minhpham1810/thuoctracker/hardware/photos/README.md

# Add real build photographs here

Suggested files (not generated or claimed to exist):

- `assembled-front.jpg`: full cabinet, 5-inch screen and manual drawers.
- `assembled-rear.jpg`: power/USB exits and cable strain relief.
- `top-wiring.jpg`: Feather, amp, mic, encoder and the common GND connection.
- `base-screen-pi.jpg`: factory screen/Pi mounts, ribbon slack and cooler clearance.

Caption whether a photograph is assembled, a work-in-progress or a CAD render.
Use your own/consented photos. Crop faces, real medication labels, usernames,
passwords, API keys and private patient data. Do not substitute AI images for
evidence that the physical build fits or works. Keep images reasonably compressed.
