minhpham1810/thuoctracker/TEAM.md

# Who does what

## Status

Newest first. Everyone (and every agent) reads this after `git pull` and adds a line after pushing something others use. Format: `- HH:MM <name> (<area>): <what changed / what is ready / what you need to do>`.

- 05:55 Thanh (docs, in Minh Dau's `docs/demo-script.md`): **Demo script: Part A timing fixed, Part C added.**
  - Minh Dau: with `DEMO=1` a pill is missed 30 s after pill time (and re-announced every 10 s until then), so in the old Part A Mary's "What do I need to take now?" at 0:48 came after Metformin was already missed. Part A now uses that: Mary takes only the aspirin, the cabinet screen turns to its **"Did you take your Metformin?" Yes / Not yet** question (the touchscreen version of your phone popup), she taps Not yet, and only then asks "Did I take my pills today?" and "When is my next pill?". Please check it reads right to you.
  - New **Part C (0:30)**: a laptop screen recording of the dashboard's **Drug safety** panel for Mary: check clarithromycin, two FDA-label warnings (low blood sugar with metformin, muscle damage with atorvastatin), then one "Ask the labels" question. It shows the FDA labels in Tiger, which the video had nowhere. Time budget added so it stays at 5:00 (trim Scene 4 and the typing in Scene 3 first).
- 05:10 Minh Dau (ai, in Minh Pham's `ai/__init__.py`): **Voice answers "what do I take now / next / today?" exactly, from the schedule.** Before, Gemma read "What do I need to take now?" as advice (the prompt said "like whether to take a pill now") and answered "I don't know". Now `_schedule_answer()` handles those questions in Python before the model is asked: "It's pill time: the blue pill, Aspirin, 1 pill from box 1."; "Your next pill is at 8 in the evening: …"; "Today: 8 in the morning, Aspirin (blue pill), taken; …". A question naming a medicine or color ("when do I take my metformin / my red pill") covers only that one. A missed pill is never "take it": "Your 12 in the afternoon Metformin was missed; please ask your doctor before taking it late."
  - The model still answers "did I take…", "what is it for" and everything else; its advice rule is narrowed to real advice (a missed or extra pill, changing a dose, symptoms), and it's told that saying what's scheduled isn't advice. Thanh's grounding checks are unchanged.
  - `ai/test_ai.py`: the "When is my next pill?" case now expects the schedule answer (no model call); the prompt-content checks moved to "How many aspirin pills do I have left?". `python -m ai.test_ai` passes.

- 04:45 Minh Dau (backend): **New pill-time announcement, every pill due now named once:** "Hi, Grandma Lan, please pay attention. You have a blue pill and a red pill. Aspirin and Metformin, now." The cabinet says it (ElevenLabs; `time_for_pill` backup sound if offline) and the screen shows it as the message. Pills due the same minute share **one** announcement: the scheduler creates all of that minute's doses first, then announces.
  - Thanh: with several pills at once, each still gets its own command, but only the first has `say_url`/`sound`; the others have both `null`. `pi/main.py` already handles that (no audio = nothing played). Tested in a throwaway schema (6 checks).

- 04:40 Thanh (backend labels): **53 FDA labels now** (15 more, already in the shared database): donepezil, memantine, tamsulosin, oxybutynin, alendronate, allopurinol, colchicine, levodopa (Sinemet), hydrochlorothiazide, carvedilol, meloxicam, trazodone, mirtazapine, zolpidem, pantoprazole. The interaction check also got more accurate: a drug class both drugs share no longer hides real effect warnings (an opioid label's "other CNS depressants" now catches zolpidem), class matches must be in a sentence about using drugs together (no more antidepressant suicidality warnings), and "strong CYP3A4 inhibitors" in a label now matches clarithromycin, fluconazole, diltiazem. Restart your backend to get it; nothing to ingest.
- 07:45 Thanh (cabinet screen): **The cabinet screen asks "Did you take your pill?" too**, so patients without their phone can answer at the cabinet. Same rules as Minh Dau's phone popup: a dose past its time, not confirmed, under 3 h ago; **Yes, I took it** / **Not yet** (asks again in 30 min); it only asks, never "take it now". It shows when no pill is being given right now (that keeps its own "I took it"), lights the pill's box, and uses a calm look instead of the red "missed" screen. Yes = the existing `POST /cabinet/{id}/taken?dose_id=`, so a missed dose sends Minh Dau's "Taken late" push and the phone popup goes away on its next check. No backend or contract change.
  - Thanh: rebuild and restart the :3000 web server; the Pi kiosk picks it up on reload (`pkill chromium`).
- 04:20 Minh Dau (app + backend): **"Did you take your pill?" popup on the patient's phone.** When a pill is due it pops up with **Yes, I took it** / **Not yet** per pill; Not yet asks again in 30 minutes; ✕ stops asking about those pills. Two pills due at once show together. It stops asking 3 hours after the pill's time, and only asks: it never says "take it now" (late double-dose risk). Yes = the same `POST /doses/{id}/taken` as "I took it".
  - Backend: Yes (or the cabinet's "I took it") on a dose already marked missed pushes the family and doctor "Taken late: Grandma Lan took Metformin (12:00) late, at 12:47." Tested in a throwaway schema (4 checks).
  - Snoozes live on the phone: reopening the app asks again right away.

- 07:20 Thanh (backend labels, ai one function, doctor dashboard panel): **Doctor AI: FDA labels for interactions and side effects** (ported from my HealthCare RAG project). 38 common drugs' DailyMed prescribing labels are now in our Tiger database: 2,886 chunks of the clinical sections, each with a MiniLM vector (pgvector + pgvectorscale DiskANN index) and a tsvector. Search ranks both ways in one SQL statement and fuses them (Reciprocal Rank Fusion). Two doctor-only routes, in the contract: `GET /patients/{id}/interactions?add=` (no AI: the sentence where one label names the other drug, plus known CYP/P-gp/additive pathways) and `POST /ai/drugs` (local Gemma answers only from numbered label passages, cites `[n]`, every number must be in a cited passage; label interaction warnings are returned separately so the model can't drop them). Dashboard: a new "Interactions and side effects" section in each patient's chart, with "Check a drug you're considering" and "Ask the labels".
  - Everyone running a backend: `git pull`, `ollama pull all-minilm` (46 MB; without it search is keyword-only), restart the backend. Nothing to ingest: the labels are already in the shared database (`python -m backend.labels ingest` refills them).
  - Minh Dau: new `backend/labels.py` (tables `drug_labels`, `label_sections`, `label_chunks`, `label_lexemes`, created on start), the two routes in `main.py` next to `/ai/ask`, and `labels.ensure_schema()` in `lifespan`.
  - Minh Pham: in `ai/__init__.py` I added `answer_from_labels` + `LABELS_DONT_SAY` + `_unsupported` only; on the web, `web/app/doctor/drug-labels.tsx` (new), one line in `dashboard.tsx`, styles at the end of `doctor.css`.
- 03:50 Minh Dau (backend + app + web): **Appointments are a month calendar now, 3 months ahead.** Doctor (dashboard Schedule tab and the app): tap a day to see its times and open new ones, with **Repeat: every <weekday> for 4, 8 or 13 weeks**, so 3 months take one click. Green days have open times; a teal dot means booked visits. Patient and family (app Visits tab): the same calendar shows which days the doctor is available; tap a green day, pick a time, book.
  - Contract: `GET /schedule` now covers 92 days by default (up to 120); `POST /availability` takes `repeat_weeks` (0-13) and inserts all the times in one statement (13 weeks of afternoons took 0.7 s).
  - Pull, restart the backend, reload the app and the dashboard. Tested in a throwaway schema: 8 new checks plus the 21 earlier ones.

- 03:20 Minh Dau (web, in Minh Pham's folder): **The doctor dashboard has a Schedule tab** next to Alerts and Messages. The doctor opens times (day, from/to, 15/30/60 min), sees each booked visit with the patient and reason (click the name to open their chart), and can remove an open time or cancel a visit (two clicks; the patient and family are told). Each patient's chart header shows **"Next visit …"**. It uses the appointment routes from the 03:00 line; `GET /schedule` joins the 3 s refresh.
  - Minh Pham: files touched: new `web/app/doctor/schedule.tsx`; `dashboard.tsx` (third tab, `slots` in `Data`, `visit` prop on `PatientView`); `lib/api.ts` (`Appointment` type); `components/icon.tsx` (`calendar`); `doctor.css` (schedule styles); `layout.tsx` (`suppressHydrationWarning` on `<html>`/`<body>`: a custom-cursor browser extension added attributes and caused the "1 Issue" hydration error). `tsc` and `eslint` pass.

- 03:00 Minh Dau (backend + app): **Doctor appointments.** The doctor opens times (a day, from-to, 15/30/60 min per visit) and sees who booked and why. The patient, or their family on the patient's behalf, books a time with an optional reason and can cancel it (the time opens again). Pushes: the doctor on each booking or cancel, the patient and family when the doctor cancels, and an "Appointment soon" reminder one hour before. No double booking even across backends; patients never see other patients' bookings. Routes are in the contract under "Appointments"; new table `appointment_slots`, created on the next backend start. `/demo/reset` seeds 4 times tomorrow 9:00-11:00 for Dr. Nguyen, Grandma Lan booked at 10:00.
  - App: the doctor gets tabs **Patients | Schedule**, the patient and family **Today | Visits | Care team**. Pull and reload (`r` in Expo).
  - Minh Pham: optional, the dashboard could show the doctor's schedule from `GET /schedule` (same doctor login).
  - Tested in a throwaway schema: 21 checks (privacy, family booking, double booking, cancel/reopen, doctor cancel notifies, past and overlapping times, roles, reminder once).
- 02:45 Thanh (ai, safety): **Voice answers can no longer invent doses.** With an empty or short log, Gemma 4 made doses up every time ("You took metformin at 8:00 AM and 8:00 PM" for Mrs. Hoa, who has no doses and no metformin: 6 of 6 tries), against the hard rule. `ai.answer` now: an empty log answers "There are no doses in your log yet." without the model; a question about a medicine not in the log answers "Your log doesn't mention X." from the data; and every medicine, pill color and time in the model's answer must be in the log (or be "now"), otherwise it says `DONT_KNOW` (and logs `[ai] answer not in the dose log (...)`). Tested: 11 canned cases (no model) plus live on Mrs. Hoa (empty) and Grandma Lan (true answers still pass).
  - Minh Pham: this is in your `ai/__init__.py` (`answer`, plus `NO_DOSES`, `COMMON_DRUGS`, `PILL_COLORS`, `TIME_RE`, `_ungrounded`); `python -m ai.test_ai` still passes.
- 02:15 Thanh (pi, screen route): **The screen shows a voice answer as the cabinet says it** (it was ~2 s early: the Pi still had to download, convert and send the audio to the ESP32). `/ai/ask` no longer saves the answer for the screen; the Pi posts it to the new `POST /cabinet/{id}/answer` right when the ESP32 has the audio, or anyway if playback fails. Contract table updated.
  - Minh Dau: that route is in `backend/main.py` next to `GET /cabinet/{id}/answer`; `/ai/ask` is back to just returning `{text, audio_url}`.
  - Thanh: on the Pi `git pull` and `sudo systemctl restart cabinet.service`.
- 02:05 Thanh (ai one setting, backend one line, screen, pi): **Voice answers come out right after they appear.** `ai.speak` now uses ElevenLabs `eleven_flash_v2_5` (same Rachel voice): ~0.75 s per sentence vs ~1.6-2 s for `eleven_multilingual_v2` (measured with our key). `ELEVENLABS_MODEL` in `.env` switches back. `/ai/ask` saves the answer for the screen only after its MP3 exists, and the screen checks every 0.5 s, so the text no longer shows seconds before the cabinet speaks. The Pi now checks commands every 0.5 s (screen tap to voice ~0.3-0.8 s) and converts each sound once. `pi/sounds/listening.mp3` re-recorded with the fast model.
  - Minh Pham: in your `ai/__init__.py` I only added `VOICE_MODEL` (env `ELEVENLABS_MODEL`) and used it in `speak`.
- 01:55 Minh Dau (app + backend): **Phone label scans: the real fix.** The 01:30 `File` workaround still failed on phones with "Unsupported FormDataPart implementation". The app now skips form uploads entirely: the picker returns the photo as base64, and the app sends it as JSON to the new `POST /ai/label64` `{image}`, which runs exactly the same label reading as `/ai/label`. Tested end to end with a phone-size photo; all 4 checks pass. The web dashboard keeps using `/ai/label`, which works in browsers.
  - Everyone: `git pull`, restart the backend, and reload the app (`r` in Expo).

- 01:45 Thanh (cabinet screen + pi; 2 backend routes): **The screen's "Ask a question" works on the Pi now.** The kiosk's browser can't use the ESP32's mic, so when the browser has no mic the button asks the cabinet instead: `POST /cabinet/{id}/ask` queues an `ask` command, the Pi says "I'm listening", records on the ESP32, calls `/ai/ask`, plays the answer; the screen shows "I'm listening" / "Let me check" and then the answer from `GET /cabinet/{id}/answer`. Laptops with a mic still record in the browser. Contract table updated.
  - Minh Dau: I added those two routes and a `cabinet_answer` table (one row per patient: last answer text + time) to `backend/main.py` / `db.py`; `/ai/ask` now also saves its answer there, and `/cabinet/{id}/command` drops an `ask` older than 30 s. Also in `seed()`'s TRUNCATE.
  - Thanh: on the Pi `git pull` and restart `cabinet.service` (it runs the ask), then reload the kiosk.
- 01:30 Minh Dau (app): **Fixed phone label scans failing with "Unsupported FormDataPart implementation".** In Expo SDK 58, `fetch` rejects React Native's old `{uri, name, type}` form part, so the photo never reached the backend. The app now uploads it as an `expo-file-system` `File`, which SDK 58 accepts. Also, the add-medicine form no longer starts pre-filled with "1 pill / 08:00 / 30", which looked like a scan result when nothing had been read. Fields start empty, with "e.g." hints. Pull and reload the app (`r` in Expo).

- 01:40 Thanh (pi + esp32): **Voice works end to end on the real cabinet.** Pi `esp32 ask` (or a talk button): the ESP32 speaker says "I'm listening. Please ask your question.", the INMP441 records 5 s, the laptop's local Gemma 4 answers from the dose log, the answer plays on the ESP32's 8 Ohm speaker. The board runs the teammate's `code.py` (volume knob + mute, Hall off, `status`) merged with the new `audio` command; it and `boot.py` are now in `pi/esp32/`. Fixes found on hardware: S3 USB endpoint limit (drive hidden in normal runs), a Linux echo at port open (ping handshake), and a CircuitPython bug where one big `readinto()` stops at half (board reads in 4 KB blocking chunks).
  - Everyone: **update the board from the Pi with `.venv/bin/python pi/esp32/push.py code.py`** (no buttons). Editing mode for the drive: hold the knob in while tapping RESET. Never hold BOOT during RESET (that's the ROM bootloader).
  - `pi/.env` on the Pi: `AUDIO=esp32` and no `audio` in `MOCK`. Stop `cabinet.service` while running bench commands, start it after.
- 00:30 Minh Dau (ai + backend): **Fixed "Couldn't read the label" for everyone.** Cause: our shared Gemini key's free tier allows `gemini-3.5-flash` only about 1-2 image requests a minute, shared by every laptop, and the Gemini fallback sent the full 3+ MB phone photo. Every scan got `429 Too Many Requests`.
  - Labels now use **`gemini-3.5-flash-lite`**: 4 scans in a row read correctly, about 7 s each.
  - The photo is shrunk for Gemini too, and a 429 waits the delay Gemini asks for (max 15 s) and retries once.
  - The app and dashboard now show the real reason on failure, e.g. "label reader failed: local model: 500 …; Gemini: 429 Too Many Requests".
  - **Minh Pham:** your Mac should have read labels with local `gemma4:e4b-mlx` before ever reaching Gemini. Scan once and check the app's message or your uvicorn console for `[ai] Ollama label read failed (...)`; that says why the local model failed (e.g. MLX not supporting images or `format`). Tell me what it says.

- 23:10 Thanh (ai, one line): **Voice questions also run on Windows/Linux with an NVIDIA GPU.** `OLLAMA_MODEL` in `.env` picks the Ollama model (default stays `gemma4:e4b-mlx` for the Mac). `gemma4:e4b` (the non-MLX build) hears audio on Ollama 0.40.5: tested on Thanh's laptop (RTX 5070) with exact transcripts, ~2 s per step once loaded, ~30 s for the first load; `/ai/ask` end to end ~7-8 s with ElevenLabs. Your label change picks up the same `gemma4:e4b` here, which is already pulled. The demo backend on Thanh's laptop now uses it, so voice no longer depends on Gemini's 20-a-day free quota (labels still do).
  - Minh Pham: I edited your `ai/__init__.py` (only `OLLAMA_MODEL = os.getenv(...)` plus a comment). The ESP32 audio path itself was tested on the Pi earlier (with the fallback answer).
- 21:45 Minh Dau (ai): **Label scanning now prefers Gemma 4** (order: gemma4, qwen2.5vl, llama3.2-vision, minicpm-v, llava). This replaces the setup steps in the 21:30 line below.
  - **Minh Pham (Mac):** nothing to pull. The `gemma4:e4b-mlx` you have for voice reads labels too, and the model is already loaded.
  - **Thanh (Windows):** `ollama pull gemma4:e4b` (the regular build, ~6.6 GB). The `-mlx` versions run only on Apple Silicon. Then `git pull`, `.venv\Scripts\pip install -r backend\requirements.txt`, and restart the backend.

- 21:30 Minh Dau (ai + backend): **Label scanning runs on local Ollama, on Windows or Mac.** `ai.read_label` sends the photo to a local vision model first and falls back to Gemini on a laptop without Ollama. Same output as before (`{name, dose, times, expiration, quantity}`), so the phone app and dashboard autofill are unchanged.
  - **Thanh (Windows) and Minh Pham (Mac):** install Ollama, run `ollama pull qwen2.5vl:7b` once (~6 GB), then `git pull`, `.venv\Scripts\pip install -r backend\requirements.txt` (adds Pillow), and restart the backend. It picks the first installed of `qwen2.5vl`, `gemma4`, `llama3.2-vision`, `minicpm-v`, `llava`, or `OLLAMA_VISION_MODEL` in `.env`. On the Mac, the `gemma4:e4b-mlx` already there for voice is the backup if qwen isn't pulled.
  - Photos are shrunk to 1280 px first. Local models answer loosely, so the result is cleaned (`8:00` → `08:00`, bad dates and times dropped, `"60 tablets"` → `60`) and anything unreadable stays empty for a person to fill in, never made up.
  - The app now waits up to 150 s for a scan; the web proxy allows 120 s.
  - Offline tests: `python -m ai.test_ai` (new cases: Ollama path, model choice, clean-up, Gemini fallback, no-model error). Not yet tried with real Ollama: please scan one real bottle on each laptop.

- 20:45 Minh Dau (app + backend): **Scan a medicine label with the phone.** In the mobile app, the doctor or the family opens the patient's Today tab → "Scan a label to add a medicine" → takes a photo (or picks one). Gemini fills in the name, dose, times, expiration and pills in the bottle. They choose a free box (1-7) and a pill color, check every field, and save. If a medicine with the same name is already there: "Aspirin was already added (box 1). Are you sure you want to add it again?"
  - Contract: `POST /medicines` now allows the patient's **family** too, not only the doctor. `/ai/label` allows family and returns a new `quantity` field. Edit and delete stay doctor-only.
  - Minh Pham: `LabelDraft` in `web/lib/api.ts` can gain `quantity: number | null` to prefill pills left on the dashboard (optional).
  - The app now uses `expo-image-picker` (camera). It works in Expo Go now; the Android APK needs a rebuild (Minh Dau is starting one), and until then the old APK says "no camera support" instead of crashing.

- 20:15 Thanh (pi): **ESP32-S3 audio unit over USB.** The speaker (MAX98357A) and mic (INMP441) are on the ESP32 (CircuitPython with `audioi2sin`); the Pi controls it over one USB cable. `pi/esp32/` has `boot.py` + `code.py` to copy onto the board and a setup README (stored sounds as 16 kHz mono WAV in `/sounds`). With `AUDIO=esp32` in `pi/.env`, `pi/main.py` plays the stored sounds and the ElevenLabs answers through it (MP3 converted on the Pi), `record_question` works, and an optional talk button on the ESP32 records a question -> `/ai/ask` -> plays the answer. Bench: `python pi/main.py esp32 ping|play good_job|rec 3|ask`. Tested against a fake board only; needs a run on the real one. New Pi dependency: `pyserial`.
  - Duy: copy `pi/esp32/boot.py` and `code.py` to the board, add the 4 WAVs, plug it into a black USB port on the Pi; set `BUTTON_PIN` in `code.py` if you wire a talk button.
- 20:00 Minh Dau (backend): **Several backends can now run at the same time on the shared database.**
  - **One scheduler:** only one backend runs it, whichever holds the `scheduler_lease` row in the database. If that laptop stops, another backend takes over within about 15 s and catches up on doses due in the gap. `GET /health` returns `"scheduler": true` on the one running it.
  - **Shared state:** the Pi command queue, cabinet screen state, "alerts already sent" and reminder times moved from process memory into tables (`cabinet_commands`, `cabinet_state`, `alerts_sent`, `doses.reminded_at`). The Pi, the cabinet screen and the dashboard can each talk to any backend.
  - **No duplicates:** each scheduler step is a conditional write, and the database allows only one dose per medicine per pill time (`doses_one_per_time`). Even if two schedulers overlap briefly, nothing is sent twice.
  - **Tested** with two backends at once against a throwaway schema, never the real tables: pill time on B reached the Pi via A; "I took it" on B showed on A; missed and expiring alerts went out exactly once to family and to doctor; after hard-killing the scheduler backend, the other took over.
  - No contract change for the Pi, web or app. New tables are created on the first start of the new code.
  - Everyone: keep laptop clocks on automatic time. Dose times still use each laptop's local clock.

- 19:45 Thanh (pi + cabinet screen): **Cabinet sign-in now accepts any patient account** (doctor/family still refused). `pi/kiosk.sh` opens plain `/cabinet`; an old `?hw=1` URL also works. Heads-up: the Pi's speaker and mic still follow `PATIENT_ID` in `pi/.env`, so sign the screen in as that same patient (Grandma Lan = 1) or the screen and the hardware will show different people. `?patient=N` still skips the sign-in.
- 19:25 Thanh (pi + cabinet screen): **Cabinet sign-in: a one-time setup on the Pi.** `/cabinet?hw=N` (what `pi/kiosk.sh` now opens; N = `PATIENT_ID` in `pi/.env`) asks once for patient N's email + password on a big built-in keyboard and remembers it; only that patient's account is accepted, so the screen always matches the Pi's boxes. Doctor/family accounts are refused; the login session is ended right away (the cabinet routes stay login-free). Menu has **Switch patient** (Cancel, or it goes back after 1 min idle). `/cabinet?patient=N` still works with no sign-in, for laptops and the demo. `kiosk.sh` dropped `--incognito` so the sign-in survives reboots. No backend change.
  - Thanh: on the Pi, `git pull`, then restart the kiosk (`pkill chromium`) and sign in once as lan@demo.com.
- 18:56 Minh Pham (app): **Fixed `npx expo start` asking to install the old global `expo-cli`.** `app/package.json` had been downgraded to `"expo": "^44.0.6"`, probably by an `npm install` when `expo-file-system` was added. Set back to `~58.0.19` and reinstalled (`npx expo --version` = 58.1.15).
  - Everyone: `git pull`, then `cd app && npm install`. Add Expo packages only with `npx expo install <pkg>`, never `npm install <pkg>`, and don't run `npm audit fix --force`: both can downgrade Expo again. If `npx expo start` offers to install `expo-cli` globally, say no.
  - Expo Go QR: on iPhone scan with the Camera app; on Android scan from inside Expo Go. Or in Expo Go tap "Enter URL manually" and type the `exp://…:8081` address it prints. Update Expo Go first (SDK 58). If the phone can't reach the laptop, use `npx expo start --go --tunnel`.

- 18:50 Minh Dau (backend + app): **The family now gets the pill-time push too**: "Time for Grandma Lan's blue pill (Aspirin), slot 1." Many older patients don't use a phone, so the family can call or help. It's sent once when the dose starts, not on every repeat reminder. In the app, the family's in-app banner shows it too (for phones without push).

- 18:40 Minh Dau (backend + app): **Alerts now go to more people.** A missed dose alerts family **and doctor**, and the patient gets an inform-only push: "You missed your 12:00 Metformin. Your family and doctor have been told." It never says "take it now", because a late pill could double up with the next dose. Expiring soon now alerts family **and doctor**. Low pills is unchanged (doctor + family). In the app, the patient's in-app banner also announces a missed dose (for phones without push).
  - Minh Pham: there are now two alert rows per missed or expiring event (`to: "family"` and `to: "doctor"`), the same as low pills already had. The dashboard may want to show only the doctor rows.
  - Heads-up: a backend test of mine ran `/demo/reset` on the shared Tiger Data database around 18:30, so anything added since the last reset was wiped back to the demo seed. Sorry. I won't test against the shared database again.

- 18:30 Thanh (cabinet screen): **Cabinet screen: dark theme + Menu button** (`web/app/cabinet/*` only, no contract change). A Menu button sits top-left. It opens: Screen Light / Dark / Auto (Auto = dark from 7 PM to 7 AM, the default), Text size Normal / Large, and Today's pills (every dose today with its box and Taken / Missed / Due now / Coming up). Tapping the Today strip also opens that list. Choices are saved in the Pi's browser. The menu closes on its own after 30 s and whenever a pill is due. Dark keeps 4.5:1 contrast everywhere.
  - Thanh: restart the :3000 server (`cd web && npx next start -H 0.0.0.0 -p 3000`) so the Pi shows it.
- 18:15 Thanh (cabinet screen): **Cabinet screen polish + accessibility pass** (`web/app/cabinet/*` only, same behavior and layout). The cabinet picture now looks like the real thing: teal body, white drawer fronts with pulls, empty boxes as dark recesses; the box to open lifts and glows with OPEN, the rest fade. Pill colour is a capsule in each box's corner; "box N" on the take screen is drawn like the glowing box. Bigger text everywhere (nothing under 14px at 800x480), Today strip shows at most 4 doses so names fit, the hero shows a mic while you ask, the lit box uses the mode colour (green taken, amber already took, red missed). A11y: box labels read pills left, refill and expiry in full; Today chips say taken/missed for screen readers; details card takes focus, closes on Escape, and the page behind it is inert. No contract change.
  - Thanh: the :3000 server reads `web/.next`, which this build rewrote: restart it (`cd web && npx next start -H 0.0.0.0 -p 3000`) so the Pi shows the new design.
- 18:05 Minh Dau (app + backend): **Real push notifications on Android.** The app is a development build now: Expo project `@minhdeptraivcl/thuoctracker` with Firebase FCM set up. Install the APK on Android phones: https://expo.dev/artifacts/eas/eGW9mu9nQSFXYmpwcVxmKkgN8vcxr0A8b4TIdMBRKus.apk
  - To run: on the laptop, `cd app`, then `$env:REACT_NATIVE_PACKAGER_HOSTNAME="192.168.137.1"; npx expo start`. Open the installed ThuocTracker app (not Expo Go), log in, and allow notifications. Alerts, pill time and chat then push even with the app closed.
  - iPhone: keep using Expo Go with `npx expo start --go`. Plain `npx expo start` now opens the development build.
  - Network: Minh Dau's laptop hotspot. Backend `http://192.168.137.1:8000`, web `http://192.168.137.1:3000`. Thanh: `BACKEND_URL=http://192.168.137.1:8000`, kiosk `http://192.168.137.1:3000/cabinet?patient=1`.
  - Push failures print as `[push error] …` in the uvicorn console.
  - Minh Pham: the dashboard's "Push sent to … phone" line appears even when no phone is registered. It's true now only if the family or doctor is logged in on a development build.

- 17:30 Thanh (pi + cabinet screen): **Contract change: the cabinet has 7 boxes, `Medicine.slot` is now 1-7.** Boxes 1-3 top row, 4-6 middle row, 7 a long box across the bottom; every box holds pills like a slot. Additive: slots 1-3 still work. Changed `models.py`, `web/lib/api.ts` (`SLOTS`, `LONG_SLOT`), the add-medicine slot picker and the dashboard's prescription cards (filled boxes plus one "add" card). **Cabinet screen redesigned** as a picture of the cabinet: the box to open glows with OPEN and the rest fade, each box shows its pills left with "Refill soon" / "Expires in N d", tapping a box opens its details, the take screen says "Open box N · take <dose>", and a Today strip along the bottom shows taken / missed / due / coming doses. Tested on the Pi touchscreen (800x480). Also: the Pi now boots straight into the kiosk with the mic flags (`pi/setup.sh`).
  - Minh Dau: please check the slot change is fine with the backend; nothing else in the backend needed changing.
  - Minh Pham: I edited `web/app/cabinet/*` and two doctor files (slot lists only). On the Pi, serve the web app with `npm run build && npx next start -H 0.0.0.0`: dev mode blocks the Pi's browser (cross-origin dev resources).

- 16:25 Minh Pham (web + ai): **Cabinet screen: "Ask a question" button** (records in the browser -> `/ai/ask` -> shows the answer big and plays the ElevenLabs MP3). Hidden while a pill is due. `ai.transcribe` now detects WAV/WebM/MP4/OGG/MP3 by itself.
  - NEED Thanh (pi): Chromium only allows the mic on https or localhost. Start the kiosk with `--unsafely-treat-insecure-origin-as-secure=http://<laptop-ip>:3000` or the Ask button says the mic isn't available. If the Pi mic is unreliable, keep using `record_question` + `/ai/ask` from `pi/main.py`.
- 16:08 Minh Pham (ai): **All the `ai/` functions are real now** (Gemini `gemini-3.5-flash` + ElevenLabs over `requests`, no new SDKs; tested live: speak, transcribe, answer). The backend's existing `try_ai` wiring picks them up, nothing to change. Checked the whole flow offline with faked APIs: `/ai/label`, `/ai/ask` -> MP3, pill time -> SMS + `say_url`. Test: `python -m ai.test_ai`.
  - Everyone: put `GEMINI_API_KEY` and `ELEVENLABS_API_KEY` in `.env` and restart the backend. Optional `ELEVENLABS_VOICE_ID`.
  - Minh Dau: I touched `backend/` only for a docstring, and fixed `.gitignore` (`.DS_Store` and `audio/` were on one line, so `audio/` MP3s were not ignored).
- 17:20 Minh Dau (backend): **Pulled Thanh's Pi loop: it matches the contract.** I fixed one backend bug it exposed. A Pi command cycle takes longer than the 10 s demo reminder, so commands piled up and an old reminder could replay after the pill was taken. Now at most one pill-time command per dose waits in the queue, and taking the pill or missing the dose removes it. Thanh: no change needed on the Pi; audio-only commands (`good_job`, `missed`) still arrive as before.
- 16:55 Minh Dau (backend): **Done: the backend no longer serves `web/`** (Minh Pham's NEED). Port 8000 is now API + `/audio/` only, and `web/` files return 404. I checked every route the Next.js pages call (`/patients`, `/alerts`, `/medicines`, `/doses/{id}/taken`, `/cabinet/{id}/state`, `/ai/label` with field `photo`, `/demo/*`): all exist with matching shapes.
  - Minh Pham: `LabelDraft` allows `null` fields. Return `None` from `read_label` for anything unreadable and the backend passes it through. Chat on the dashboard is optional; the mobile app already has it.

- 15:50 Minh Pham (frontend): **Doctor dashboard + cabinet screen are live on the real API**, now a Next.js app in `web/` (whole folder is mine). Run `cd web && npm install && npm run dev` → dashboard `http://<laptop-ip>:3000/doctor`, cabinet `http://<laptop-ip>:3000/cabinet?patient=1`. The browser calls `/api/*` on :3000, which proxies to the backend (`BACKEND_URL`, default `http://localhost:8000`), so no CORS needed. Dashboard has "Pill time now" (calls `/demo/pill_time`) and "Add medicine" (label photo → `/ai/label` → form → `POST /medicines`).
  - Minh Dau: the dashboard moved from static `web/doctor` to Next.js, so it is no longer served on :8000. It handles cabinet `mode: "missed"` and the new alerts; chat on the dashboard is not built yet.
  - NEED Thanh (pi): the kiosk URL is now `http://<laptop-ip>:3000/cabinet?patient=1` (port 3000, not 8000).
  - NEED Minh Dau (backend): please delete the `app.mount("/", StaticFiles(directory="web", ...))` line in `backend/main.py`. `web/` is Next.js source now, so that mount would serve `node_modules`, `.next` and any `web/.env*` file to anyone on the hotspot.
- 16:40 Minh Dau (app): **First version of the mobile app is in `app/`.** Pick a role (patient, family or doctor). The doctor sees all their patients with taken/missed counts and refill badges; each patient has a Today tab (medicines, pills left, alerts, dose history, "take your pill" banner) and a Chat tab shared by patient, family and doctor. Phone notifications show while the app is running; real push turns on after `npx eas init` (Android also needs a development build). To try it: `cd app && npm install && npx expo start`, open it in Expo Go, and enter `http://<laptop-ip>:8000`. Nobody else needs to change anything.
- 16:00 Minh Dau (backend + app): **Adding a mobile app** (Expo, in `app/`, built by Minh Dau) for patients, families and doctors, with a chat per patient and push notifications. The backend part is ready: chat routes, push registration, and every alert sent by both push and SMS (see "Mobile app" in the contract). Added a 3rd sample patient, Mrs. Hoa.
  - Minh Pham: the web doctor dashboard stays (it's the big screen at the judging table), with no change needed. Optional: show the patient chat on the dashboard with `GET /patients/{id}/messages`.
- 15:35 Minh Dau (backend): **The AI routes now call `ai/`.** `/ai/label` and `/ai/ask` call `read_label`, `transcribe`, `answer` and `speak`. A function that still raises `NotImplementedError` gets a fake answer, so Minh Pham can push one function at a time and it goes live with no backend change.
  - Minh Pham: match the signatures in `ai/__init__.py` exactly. `answer(question, log)` receives the dose-log shape in this file (contract change 4). `speak` returns MP3 bytes; the backend saves them and serves them at `/audio/…`. Make sure `import ai` never crashes, or the backend won't start.
  - Thanh: `say_url` and `audio_url` become real MP3 links (prefix with `BACKEND_URL`) once `speak` is written; while they're `null`, play the backup `sound`. After a dose the Pi also gets `{"sound": "good_job"}` or `{"sound": "already_took"}`.
- 15:20 Minh Dau (backend): **The scheduler is running.** Pill time starts a dose on its own, the reminder repeats, a dose with no pill taken is marked missed, and the low-pills and expiring alerts fire once each. Texts go through Twilio, or are printed to the console when `.env` has no keys. Put `DEMO=1` in `.env` for the 30 s missed / 10 s reminder timing.
  - Thanh: **contract change.** A command may be audio only (e.g. `{"dose_id": 7, "sound": "missed"}`): just play the sound. The same `dose_id` can arrive again as a repeat reminder: play it again.
  - Minh Pham: the cabinet `/state` can now be `mode: "missed"`. New alerts appear in `/alerts` on their own, so poll with `?since=`.
- 15:10 Minh Dau (backend): **API is live on in-memory sample data.** Every route in the contract below works with the exact JSON shapes. Run `uvicorn backend.main:app --reload --host 0.0.0.0` from the repo root, or use Minh Dau's laptop IP on the hotspot, port 8000. Fake pill time: `POST /demo/pill_time?medicine_id=1`; reset: `POST /demo/reset`.
  - Minh Pham: build the dashboard on `/patients`, `/patients/{id}/medicines`, `/patients/{id}/doses`, `/alerts`; the cabinet screen polls `/cabinet/1/state`. `/ai/label` and `/ai/ask` return fixed fake answers until your `ai/` functions are pushed. Add a Status line when each one is ready.
  - Thanh: the Pi polls `/cabinet/1/command`. `say_url` is `null` for now, so play the backup sound named in `sound`.
  - `models.py`: `Patient.phone` (required) and `Doctor.phone` (optional) were added.
  - Not done yet: the scheduler (timed reminders, missed doses, low and expiring alerts) and Twilio.

4 people. Each person owns **folders**, not features, so nobody edits the same file. Duy joins later for the physical build.

| Person | Owns (only you edit these) | Done means |
|---|---|---|
| **Minh Dau**: Backend + mobile app | `backend/` (all of it: `main.py`, `models.py`, rules, Twilio, push, the `/ai/*` route wrappers) and `app/` (Expo mobile app for patient, family, doctor: chat + push) | Every endpoint below returns real data; alerts and texts fire on their own |
| **Minh Pham**: AI + Frontend | `ai/__init__.py`, `web/` (Next.js: `/doctor`, `/cabinet`) | The 5 AI functions work alone; dashboard and cabinet screen run on the real API |
| **Thanh**: Raspberry Pi code | `pi/` (code, backup sounds, Pi software setup) | Pi polls the backend, sends voice recordings, plays audio |
| **Duy**: Hardware (joins later) | The physical cabinet: wiring, drawers, screen mount, audio parts, box. No repo folder | Thanh's code runs on real parts instead of mock mode |

Rules that stop overlap:

- **AI functions stay pure.** Minh Pham writes `read_label`, `transcribe`, `answer`, `speak` (bytes/text in, data out, no FastAPI, no DB). Minh Dau calls them from the routes.
- **Only the backend decides.** The Pi never logs a dose itself: the patient's "I took it" goes to the backend, which decides "taken". The screens never compute alerts: they show what the API returns.
- **`models.py` is Minh Dau's.** Need a field? Ask in the group chat; Minh Dau adds it and tells everyone.
- Need something in someone else's folder? Message them, don't edit it.

## The API contract (agree in Hour 0, then don't break it)

Minh Dau's first job is making **every route below return fake data within the first hour**, so Minh Pham and Thanh can build against it right away. Then fill in the real logic behind the same shapes.

### Accounts and auth

Data lives in Tiger Data (Postgres, `DATABASE_URL` in `.env`). **Several backends can run against one database at once.** Only one runs the scheduler (whoever holds the `scheduler_lease` row; another takes over within ~15 s if it stops), and the Pi queue and cabinet screen state are in the database, so the Pi, screen and dashboard can each talk to any backend. `GET /health` says `"scheduler": true` on the one running it. Keep laptop clocks on automatic time.

One `users` table, one role per account. Patient: `age`, `doctor_id`. Family: `patient_id`. Demo accounts (password `demo1234`): `doctor@demo.com`, `mary@demo.com` (patient 1), `emily@demo.com` (Mary's family); also `robert@`, `linda@`, `david@`, `susan@demo.com`.

App and dashboard routes need `Authorization: Bearer <token>` (401 without it). Cabinet routes and `/demo/*` are login-free.

| Route | Who | Returns |
|---|---|---|
| `POST /signup` `{role, name, email, password, age?, doctor_email?, patient_email?}` | anyone | `{token, user}`. Patient needs `age` + an existing doctor's email; family needs an existing patient's email. 409 if the email is taken |
| `POST /login` `{email, password}` | anyone | `{token, user}`; 401 "Wrong email or password" |
| `POST /login/auth0` `{access_token, new_doctor?}` | anyone | `{token, user}`. "Continue with Auth0" on the dashboard and in the app: the backend checks the token with Auth0 `/userinfo` (`AUTH0_DOMAIN` in `.env`). A new email gets a doctor account (`new_doctor`, default true; the app sends false and gets 404 "Create an account" instead); an existing account needs the email verified in Auth0 (else 401). 503 if `AUTH0_DOMAIN` isn't set |
| `POST /logout`, `GET /me` | logged in | `{ok}`, the `User` |
| `GET /contacts` | logged in | `[{user, unread, last}]`: their care circle. Doctor: patients + their families. Patient: doctor + family. Family: patient + doctor |
| `GET /messages?with_id=&since=` | logged in | `[Message]` `{id, from_id, to_id, text, at}` oldest first; with `with_id`, also marks that person's messages read |
| `POST /messages` `{to_id, text}` | logged in | `Message`; 403 outside the circle; pushes to `to_id` |
| `GET /alerts?since=` | logged in | Doctor: every alert about their patients. Family: their patient's family alerts. Patient: `[]` |
| `POST /push/register` `{token}` | logged in | Expo push token, kept on this login (logout stops pushes) |

### Data + doctor dashboard

| Route | Who | Returns |
|---|---|---|
| `GET /patients/{id}/medicines`, `GET /patients/{id}/doses` | patient, their family, their doctor | `[Medicine]`, `[DoseLog]` newest first |
| `POST /medicines` | the patient's doctor or family | `Medicine` with `id`; 409 if the slot is taken |
| `PATCH /medicines/{id}` (any fields) | the patient's doctor | updated `Medicine` (refill = `pills_left`) |
| `DELETE /medicines/{id}` | the patient's doctor | `{ok}`; its doses go too |
| `POST /doses/{id}/taken` | the patient | `DoseLog` (phone "I took it") |
| `POST /ai/label64` `{image: <base64>}` | doctors and family | same as `/ai/label`, photo as base64 JSON (the phone app uses this; SDK 58's fetch can't send multipart files from a phone) |
| `POST /ai/label` (photo) | doctors and family | `{name, dose, times, expiration, quantity}` draft for the add-medicine form (`quantity` = pills in the bottle; any field may be `null`) |
| `POST /ai/drugs` `{question, patient_id?}` | doctor (of that patient) | `{answer, medicines, searched, sources: [{n, drug, label, section, version, effective, text, url}]}`: local Gemma answers only from FDA label passages and cites them `[n]`; every number must be in a cited passage, else "The loaded FDA labels don't answer that." Searches the patient's medicines' labels plus any drug the question names. 503 if no labels are loaded |
| `GET /patients/{id}/interactions?add=` | the patient's doctor | `{medicines: [{name, drug, label}], pairs: [{drugs, label_says: [{label_of, names, by, section, sentence, label, url, ...}], pathways: [{mechanism, source, why}], labels_checked}], loaded: [drug names with a label], note}`: no AI. For each pair of the patient's medicines (plus `add`, a drug being considered), the sentence where one FDA label names the other, and known CYP/P-gp/additive pathways |

### Appointments

The doctor opens times; the patient, or their family, books one. Booking is one conditional `UPDATE`, so two people (or two backends) can't both get the same time. Patients and family never see other patients' bookings.

| Route | Who | Returns |
|---|---|---|
| `GET /schedule` | logged in | `[Appointment]` `{id, doctor_id, doctor_name, starts_at, minutes, patient_id, patient_name, booked_by, reason}`, today + 92 days (`?days=` up to 120). Doctor: all their times, open (`patient_id: null`) and booked. Patient/family: the doctor's open future times + the patient's own visits |
| `POST /availability` `{day: "YYYY-MM-DD", start: "09:00", end: "12:00", minutes: 15\|20\|30\|45\|60, repeat_weeks: 0-13}` | doctor | `{added: [Appointment], skipped: n}`: one time every `minutes`, on `day` and the same weekday for `repeat_weeks` more weeks; past times, overlaps and days more than 120 days out are skipped |
| `POST /slots/{id}/book` `{patient_id?, reason?}` | the patient, or their family (`patient_id` = their patient) | `Appointment`; 409 if just taken or past. Pushes the doctor, and the rest of the patient's circle |
| `POST /slots/{id}/cancel` | the patient or their family | `Appointment` (open again); 409 if not booked or already started. Pushes the doctor + circle |
| `DELETE /slots/{id}` | the doctor | `{ok}`; if it was booked, the patient + family get "Appointment cancelled" |

The scheduler pushes "Appointment soon" to the patient and family one hour before each visit, once.

### Cabinet: two pollers, two routes

The Pi and the cabinet screen both poll. If they share one route, whoever reads first "eats" the command. So:

| Route | Who calls it | Returns |
|---|---|---|
| `GET /cabinet/{id}/command` | **Pi only.** Each command is given out once | `{}` or `{"dose_id": 7, "say_url": "/audio/7.mp3", "sound": "time_for_pill"}` |
| `GET /cabinet/{id}/state` | **Screen only.** Read-only, safe to poll | `{"mode": "idle" \| "take" \| "taken" \| "already_took" \| "missed", "dose_id", "slot", "medicine", "color", "message"}` |
| `GET /cabinet/{id}/today` | Screen | `{name, medicines, doses}` |
| `POST /cabinet/{id}/taken?dose_id=7` | Screen "I took it" button | updated `DoseLog` |
| `POST /cabinet/{id}/ask` | Screen "Ask a question" when its browser has no mic (the Pi kiosk: the mic is on the ESP32). Queues `{"ask": true, "at"}` for the Pi; dropped if the Pi doesn't take it within 30 s | `{"at": "2026-10-25T01:35:24.9"}` |
| `GET /cabinet/{id}/answer` | Screen: the last voice answer (set by the Pi as the cabinet starts saying it); show it once `at` is newer than the ask's `at` | `{"text", "at"}` or `{}` |
| `POST /cabinet/{id}/answer` `{"text"}` | Pi: "the cabinet is starting to say this now" (after the ESP32 took the audio; also if playback failed) | `{"ok": true}` |
| `POST /ai/ask?patient_id=1` (audio) | Pi | `{"text": "...", "audio_url": "/audio/q12.mp3"}` |
| `GET /audio/{file}.mp3` | Pi | MP3 the backend made with `speak()` |

Some commands only play a stored sound (e.g. `{"dose_id": 7, "say_url": null, "sound": "missed"}`). The same dose can arrive again as a repeat reminder. `sound` is one of `time_for_pill`, `good_job`, `already_took`, `missed`. If `say_url` fails to download, the Pi plays its stored file with that name.

Every alert goes to the dashboard and by push to that role's phones. Pill time pushes to the patient's phone too.

### Demo controls (Minh Dau)

- `DEMO=1` in `.env`: missed after 30 s instead of 30 min, reminder repeat 10 s instead of 10 min.
- `POST /demo/pill_time?medicine_id=1`: start a dose right now (don't wait for 8:00).
- `POST /demo/reset`: reload the sample patients.

## Contract changes to make in Hour 0 (Minh Dau, in `models.py`)

1. `Patient.phone`: the reminder text goes to the patient's own phone, but only `family_phone` exists today.
2. `Doctor.phone` (optional): only if we want refill alerts as SMS too; otherwise doctor alerts just show on the dashboard.
3. `Medicine.slot` is `1`-`7` (boxes 1-3 top row, 4-6 middle row, 7 the long bottom box; changed from 1-3 at 17:30). Two medicines can't share a slot: reject in `POST /medicines`.
4. Dose log passed to `answer()`: a list of `{"medicine": "Aspirin", "due_at": iso, "status": "taken", "taken_at": iso}`. Minh Pham codes against this shape. Third argument (optional): the patient's medicines as `Medicine` JSON, so it can answer "when is my next pill", "which box", "how many left".

## Each person's task list

### Minh Dau: Backend

**Hours 0-1**
- Make the `models.py` changes above, push, post in chat.
- Stub every route in the contract with fake JSON. Push. This unblocks everyone.

**Hours 1-6**
- In-memory store (`db` dict) for patients, medicines, doses, alerts. SQLite only if time allows.
- Real CRUD routes. Sample data loader (1 doctor, 2 patients, 3 medicines).
- `/cabinet/{id}/command` queue + `/cabinet/{id}/state`.
- "I took it" → taken logic. Wrap `/ai/label` and `/ai/ask` around Minh Pham's functions (use fake returns until theirs are ready).

**Hours 6-10**
- Scheduler (background loop every few seconds): pill time → create `pending` dose, push command, SMS patient; repeat reminder; missed → SMS family; `pills_left < 5` → `low_pills`; expiration ≤ 7 days → `expiring_soon`. Don't send the same alert twice.
- "Already took" check: second open of a `taken` dose → state `already_took`, sound `already_took`.
- Twilio texts (verify everyone's numbers on the trial account first).
- Save `speak()` MP3s to a folder and serve them at `/audio/`.

**Hours 14-18**: demo routes, bug fixes, realistic sample data.

### Minh Pham: AI + Frontend

**Hours 1-6**
- `read_label`: Gemini on 3 real bottles. Return JSON only, `expiration` as `YYYY-MM-DD`, `times` as `["08:00"]`.
- Doctor dashboard against Minh Dau's fake API: patient list, each patient's medicines + pills left, dose history (taken/missed), alerts panel.
- Cabinet screen: big message, slot highlighted in the medicine's color, big "I took it" button. Polls `/state` every 1 s.

**Hours 6-10**
- `transcribe` (Gemini audio or ElevenLabs STT), `answer` (only from the dose log; if the log doesn't say, answer "I don't know, ask your doctor"), `speak` (ElevenLabs → MP3 bytes).
- Dashboard: "Add medicine from photo" (upload → `/ai/label` → pre-filled form → `POST /medicines`).
- Switch both pages from fake to real API.

**Hours 14-18**: polish, live alerts, demo video.

### Thanh: Raspberry Pi

Duy wires the hardware later, so write the code first with a **mock mode**: `MOCK=1 python pi/main.py` uses a test WAV instead of the mic, and the laptop speaker. Then flip to real parts one at a time as Duy connects them.

**Hours 1-6**
- Pi OS, join the hotspot, open `http://<laptop-ip>:3000/cabinet?patient=1` full-screen in Chromium kiosk mode.
- Poll loop against Minh Dau's fake `/command`. Mock mode working end to end.
- Keep each hardware call (`play_mp3`, `record_question`) behind the mock flag so Duy can test one part at a time.

**Hours 6-10**
- Real flow per command: play `say_url` (or the backup sound).
- Voice: a button (or screen tap) records 5 s → `POST /ai/ask` → play `audio_url`.
- Record the 4 backup sounds (`time_for_pill`, `good_job`, `already_took`, `missed`) into `pi/sounds/`.

**Hours 14-18**: run the full flow on real hardware with Duy, fix timing bugs.

### Duy: Hardware (when you join)

Wiring tables are in the team plan PDF (Pi wiring section).
- Audio: `dtoverlay=googlevoicehat-soundcard` for the INMP441 + MAX98357A, **1 hour max**, then switch to the ESP32 speaker backup.
- Touchscreen per Freenove's guide.
- Box: 7 drawers, box labels, tidy cables.
- Tell Thanh each time a part works so they can turn off mock mode for it.

## When we connect (hours 6-10)

Order, so a failure is easy to find:
1. Pi mock mode ↔ real backend (no hardware).
2. Cabinet screen ↔ real backend.
3. Audio.

Run the full demo script (README / team plan) once at hour 10, again at hour 18.
