minhpham1810/thuoctracker/hardware/photos/base-and-pi.jpg

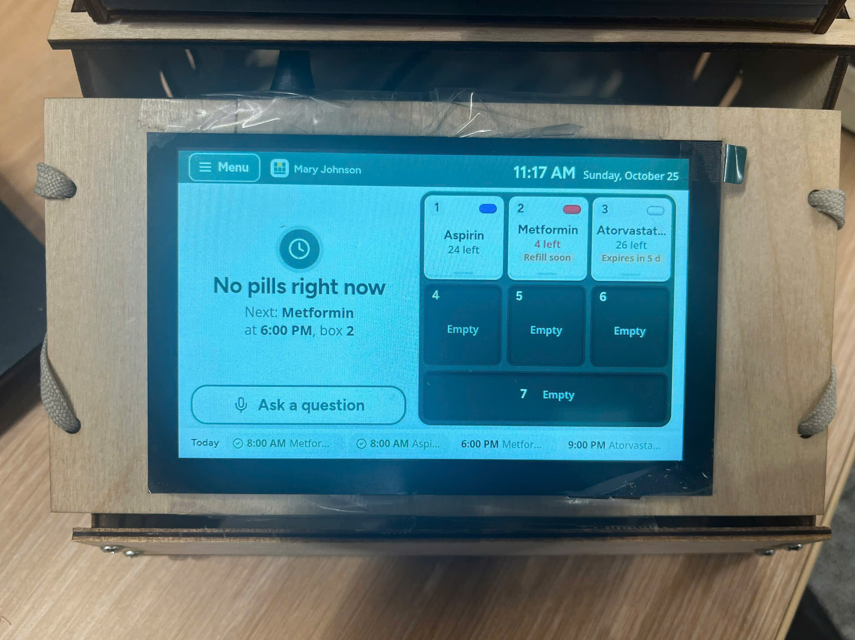
hardware/photos/base-and-pi.jpg
