minhpham1810/thuoctracker/pi/mock/slot.jpg

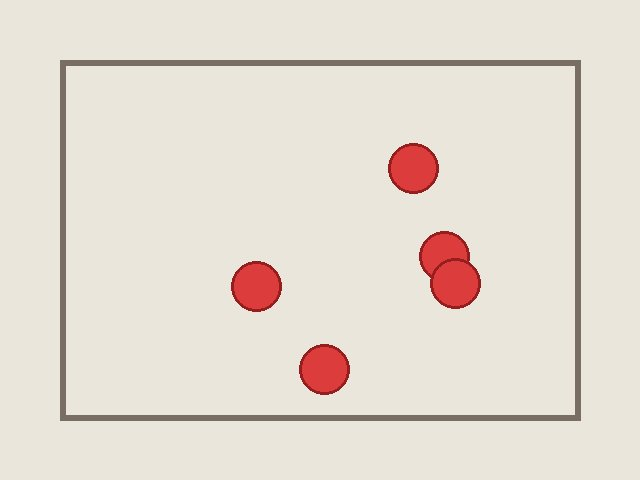
pi/mock/slot.jpg
