minhpham1810/thuoctracker/hardware/dxf/frame/frame_top_QTY1.dxf

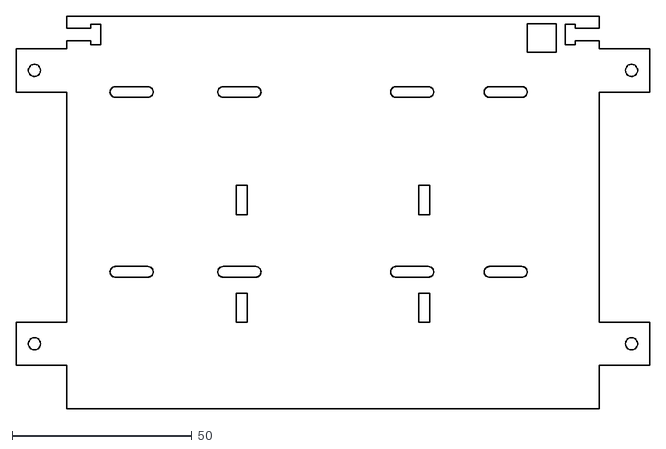
[picture p9: CAD file, 2026-10-25]
hardware/dxf/frame/frame_top_QTY1.dxf
176.0 x 109.0
