minhpham1810/thuoctracker/hardware/dxf/optional/servo_arm_QTY3.dxf

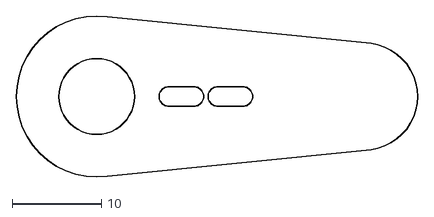
[picture p10: CAD file, 2026-10-25]
hardware/dxf/optional/servo_arm_QTY3.dxf
45.0 x 18.0
