minhpham1810/thuoctracker/hardware/dxf/top/upper_spacer_QTY4.dxf

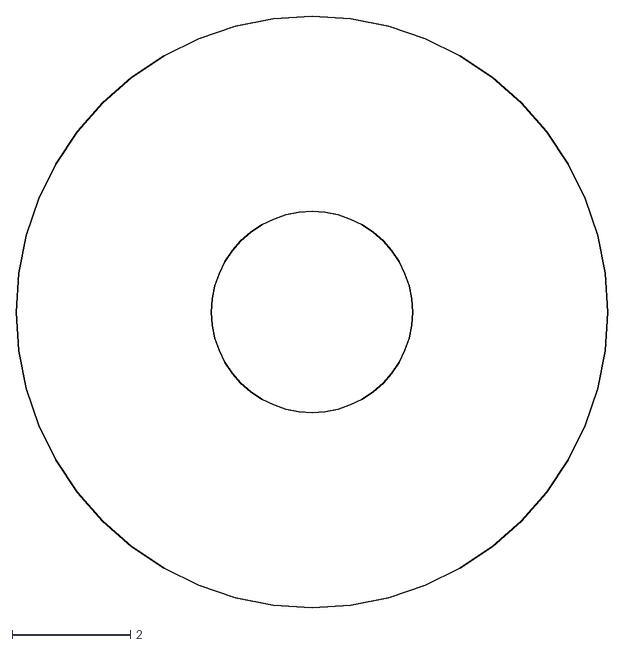
[picture p11: CAD file, 2026-10-25]
hardware/dxf/top/upper_spacer_QTY4.dxf
10.0 x 10.0
