minhpham1810/thuoctracker/hardware/stl/wide_drawer.stl

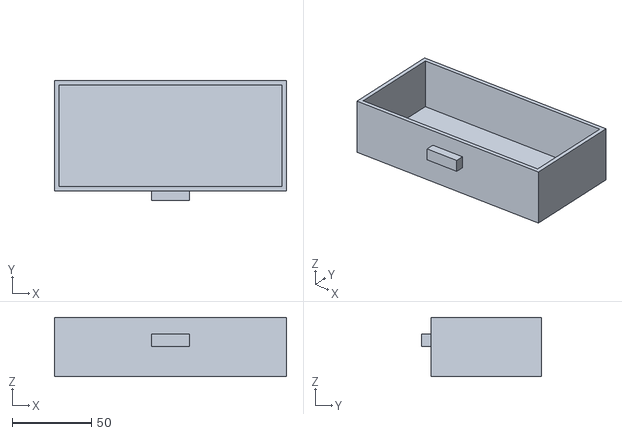
[picture p12: CAD file, 2026-10-25]
hardware/stl/wide_drawer.stl
146.8 x 76.0 x 37.6
