minhpham1810/thuoctracker/hardware/dxf/bottom/base_floor_QTY1.dxf

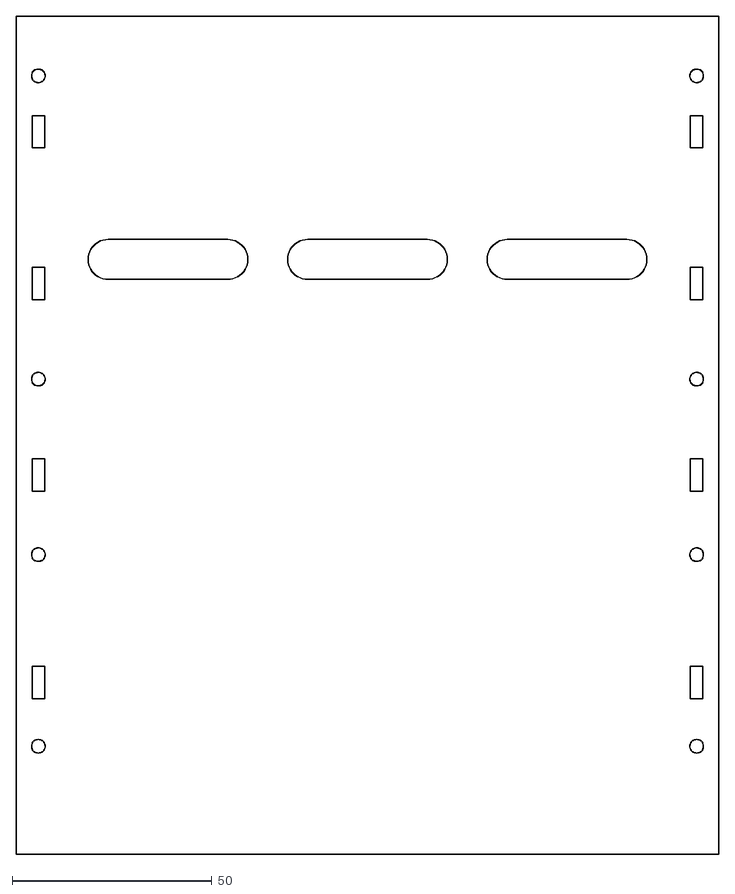
[picture p13: CAD file, 2026-10-25]
hardware/dxf/bottom/base_floor_QTY1.dxf
176.0 x 210.0
