minhpham1810/thuoctracker/hardware/dxf/frame/frame_divider_QTY4.dxf

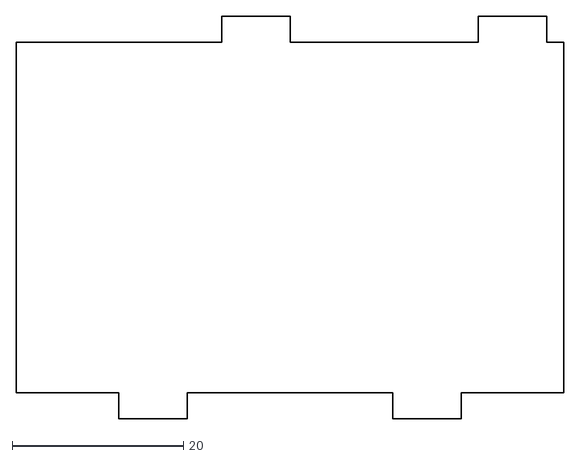
[picture p14: CAD file, 2026-10-25]
hardware/dxf/frame/frame_divider_QTY4.dxf
64.0 x 47.0
