minhpham1810/thuoctracker/hardware/dxf/optional/servo_strip_QTY12.dxf

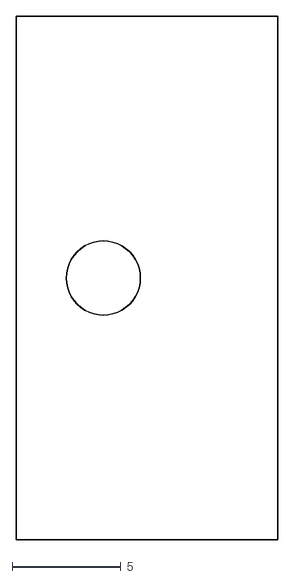
[picture p15: CAD file, 2026-10-25]
hardware/dxf/optional/servo_strip_QTY12.dxf
12.0 x 24.0
