minhpham1810/thuoctracker/hardware/dxf/top/upper_side_QTY2.dxf

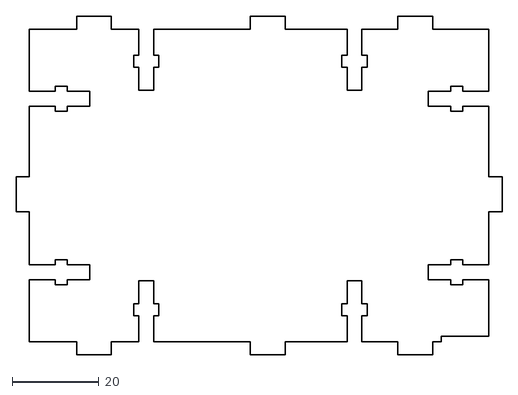
[picture p16: CAD file, 2026-10-25]
hardware/dxf/top/upper_side_QTY2.dxf
112.0 x 78.0
