minhpham1810/thuoctracker/hardware/stl/last_small_drawer.stl

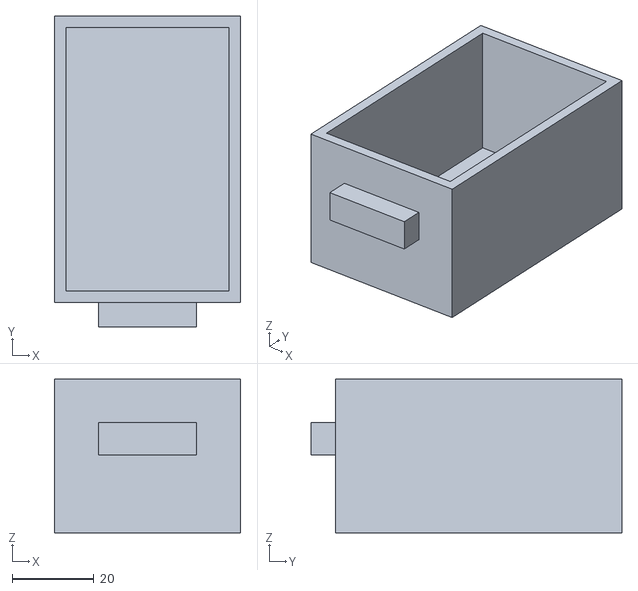
[picture p17: CAD file, 2026-10-25]
hardware/stl/last_small_drawer.stl
45.5 x 76.0 x 37.6
