minhpham1810/thuoctracker/hardware/dxf/frame/frame_back_QTY1.dxf

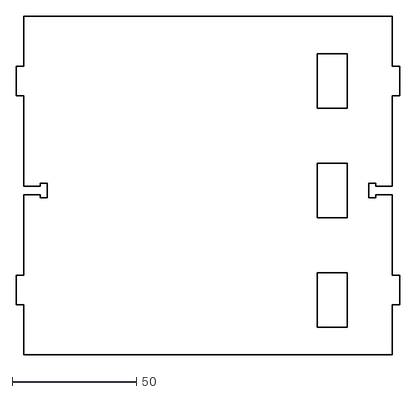
[picture p19: CAD file, 2026-10-25]
hardware/dxf/frame/frame_back_QTY1.dxf
154.0 x 136.0
