minhpham1810/thuoctracker/hardware/dxf/bottom/base_side_QTY2.dxf

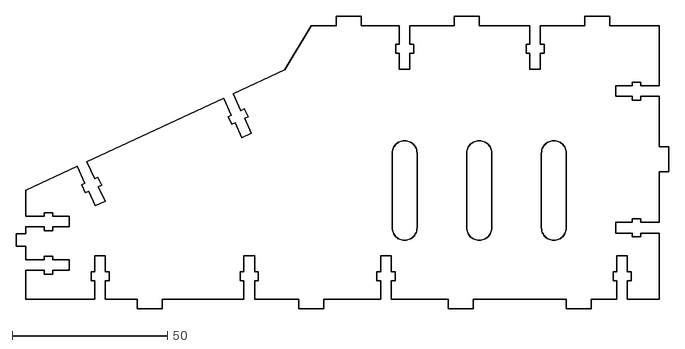
[picture p21: CAD file, 2026-10-25]
hardware/dxf/bottom/base_side_QTY2.dxf
210.0 x 94.0
