minhpham1810/thuoctracker/hardware/dxf/frame/frame_shelf_middle_QTY1.dxf

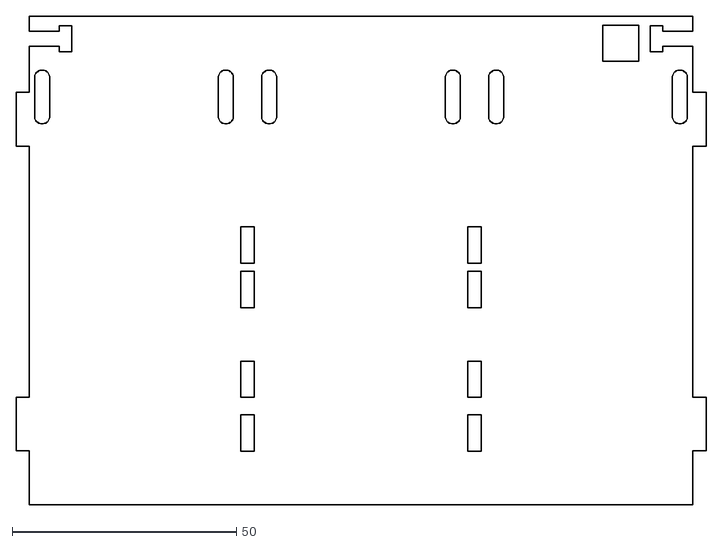
[picture p22: CAD file, 2026-10-25]
hardware/dxf/frame/frame_shelf_middle_QTY1.dxf
154.0 x 109.0
