minhpham1810/thuoctracker/hardware/dxf/frame/frame_shelf_lower_QTY1.dxf

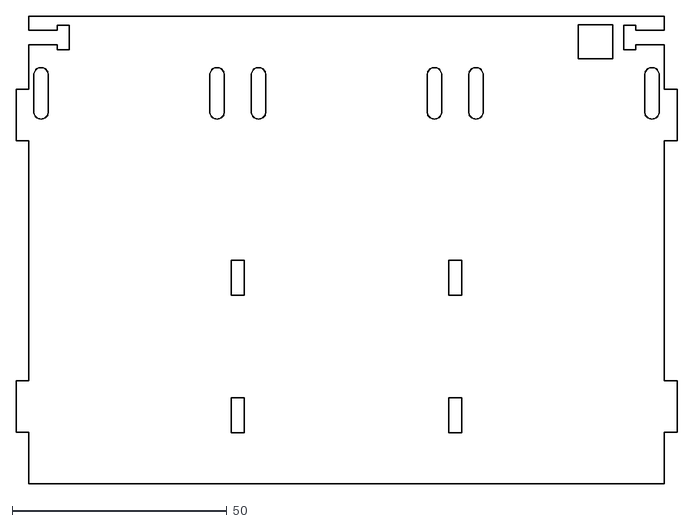
[picture p25: CAD file, 2026-10-25]
hardware/dxf/frame/frame_shelf_lower_QTY1.dxf
154.0 x 109.0
