minhpham1810/thuoctracker/hardware/dxf/top/upper_floor_QTY1.dxf

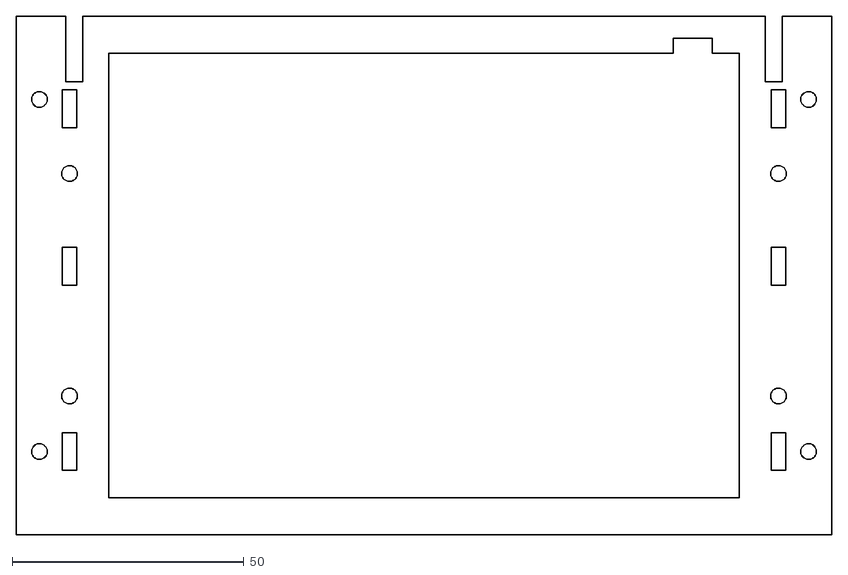
[picture p26: CAD file, 2026-10-25]
hardware/dxf/top/upper_floor_QTY1.dxf
176.0 x 112.0
