minhpham1810/thuoctracker/hardware/dxf/bottom/base_front_QTY1.dxf

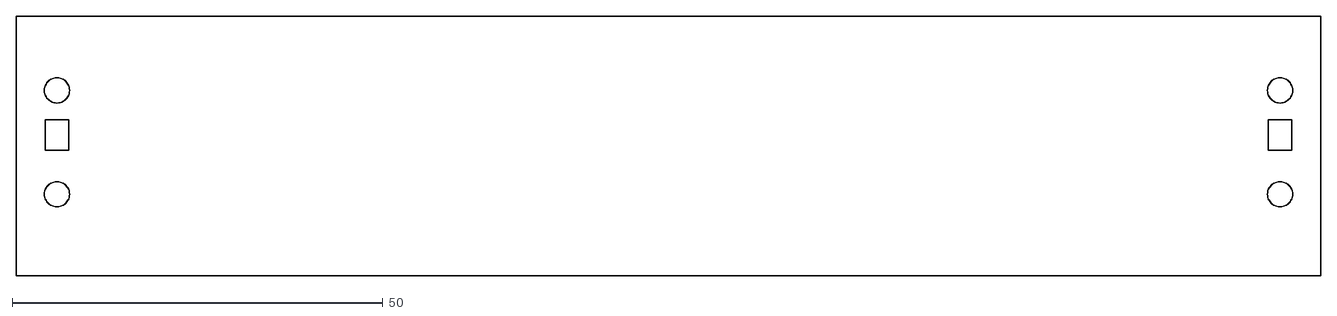
[picture p27: CAD file, 2026-10-25]
hardware/dxf/bottom/base_front_QTY1.dxf
176.0 x 35.0
