minhpham1810/thuoctracker/hardware/dxf/frame/frame_side_QTY2.dxf

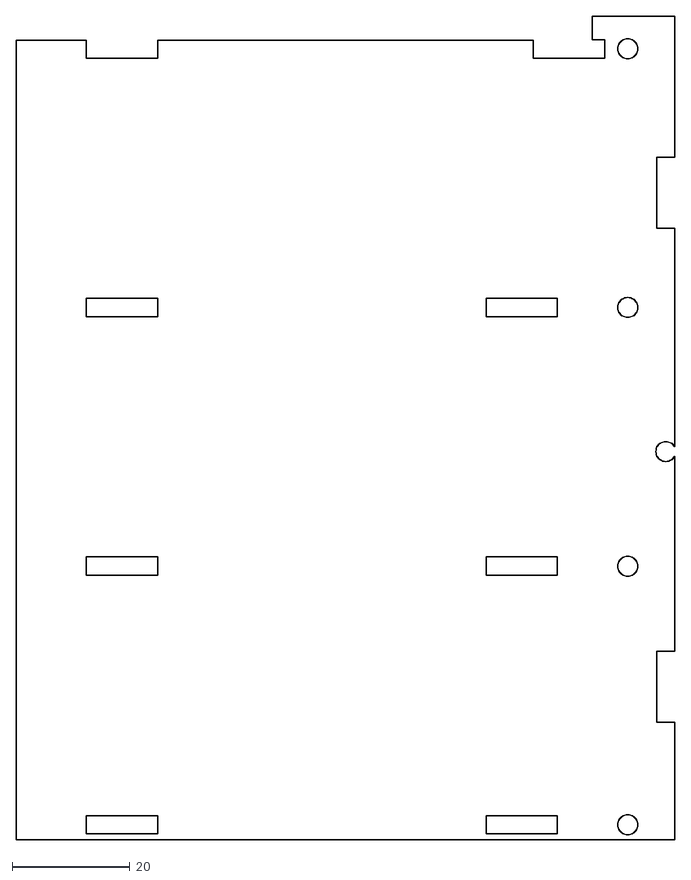
[picture p28: CAD file, 2026-10-25]
hardware/dxf/frame/frame_side_QTY2.dxf
112.0 x 140.0
