minhpham1810/thuoctracker/hardware/dxf/top/speaker_ring_QTY1.dxf

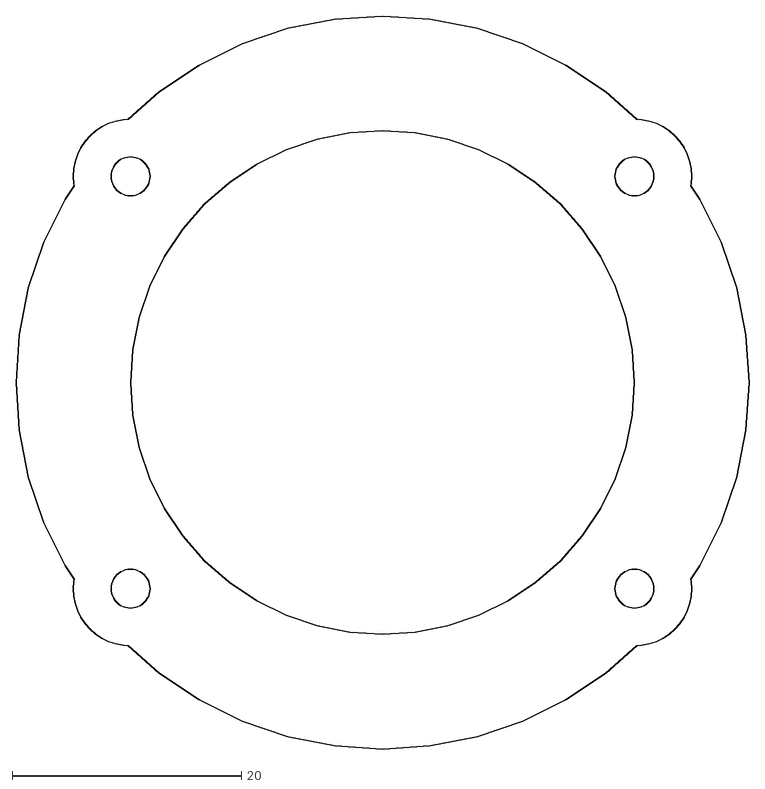
[picture p29: CAD file, 2026-10-25]
hardware/dxf/top/speaker_ring_QTY1.dxf
64.0 x 64.0
