minhpham1810/thuoctracker/hardware/dxf/bottom/base_deck_QTY1.dxf

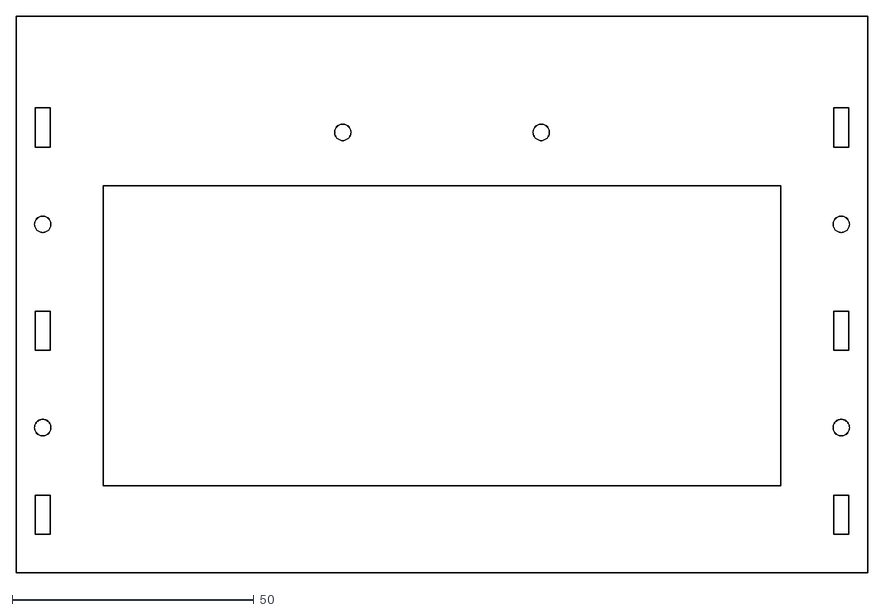
[picture p30: CAD file, 2026-10-25]
hardware/dxf/bottom/base_deck_QTY1.dxf
176.0 x 115.0
