minhpham1810/thuoctracker/hardware/cad/assembled-preview.png

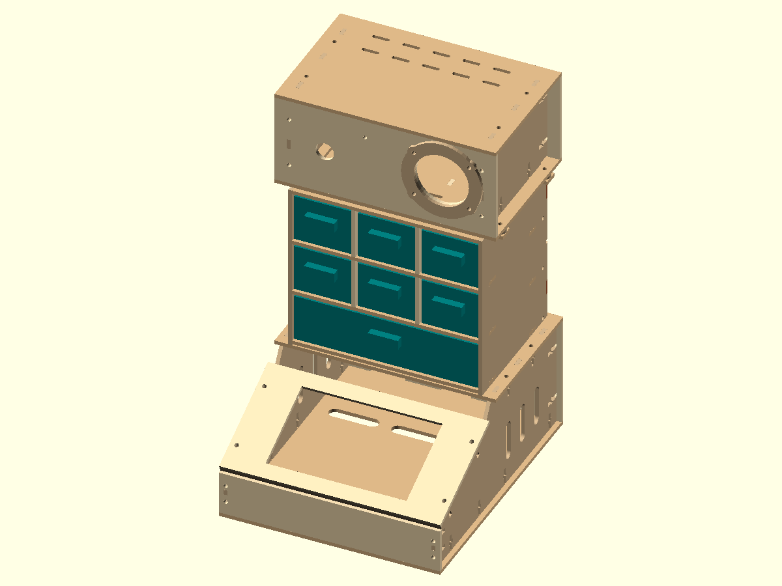
hardware/cad/assembled-preview.png
