minhpham1810/thuoctracker/hardware/photos/assembled-rear.jpg

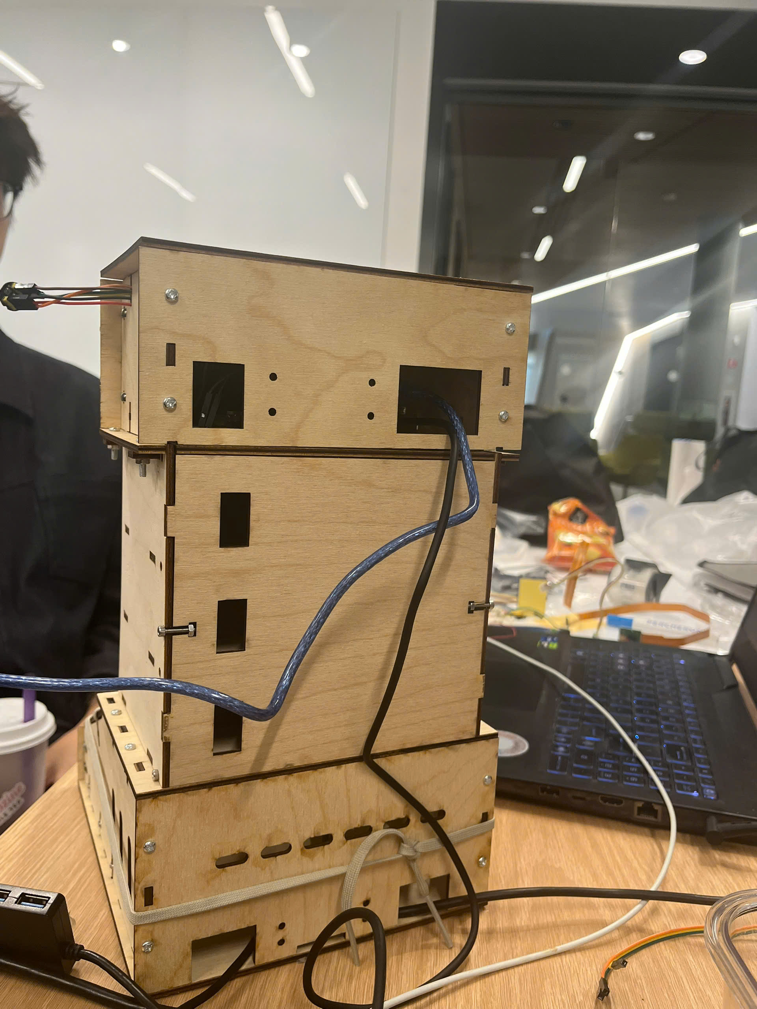
hardware/photos/assembled-rear.jpg
