minhpham1810/thuoctracker/hardware/schematic/cabinet.kicad_sch

## KiCad design hardware/schematic/cabinet.kicad_sch (2026-10-25)

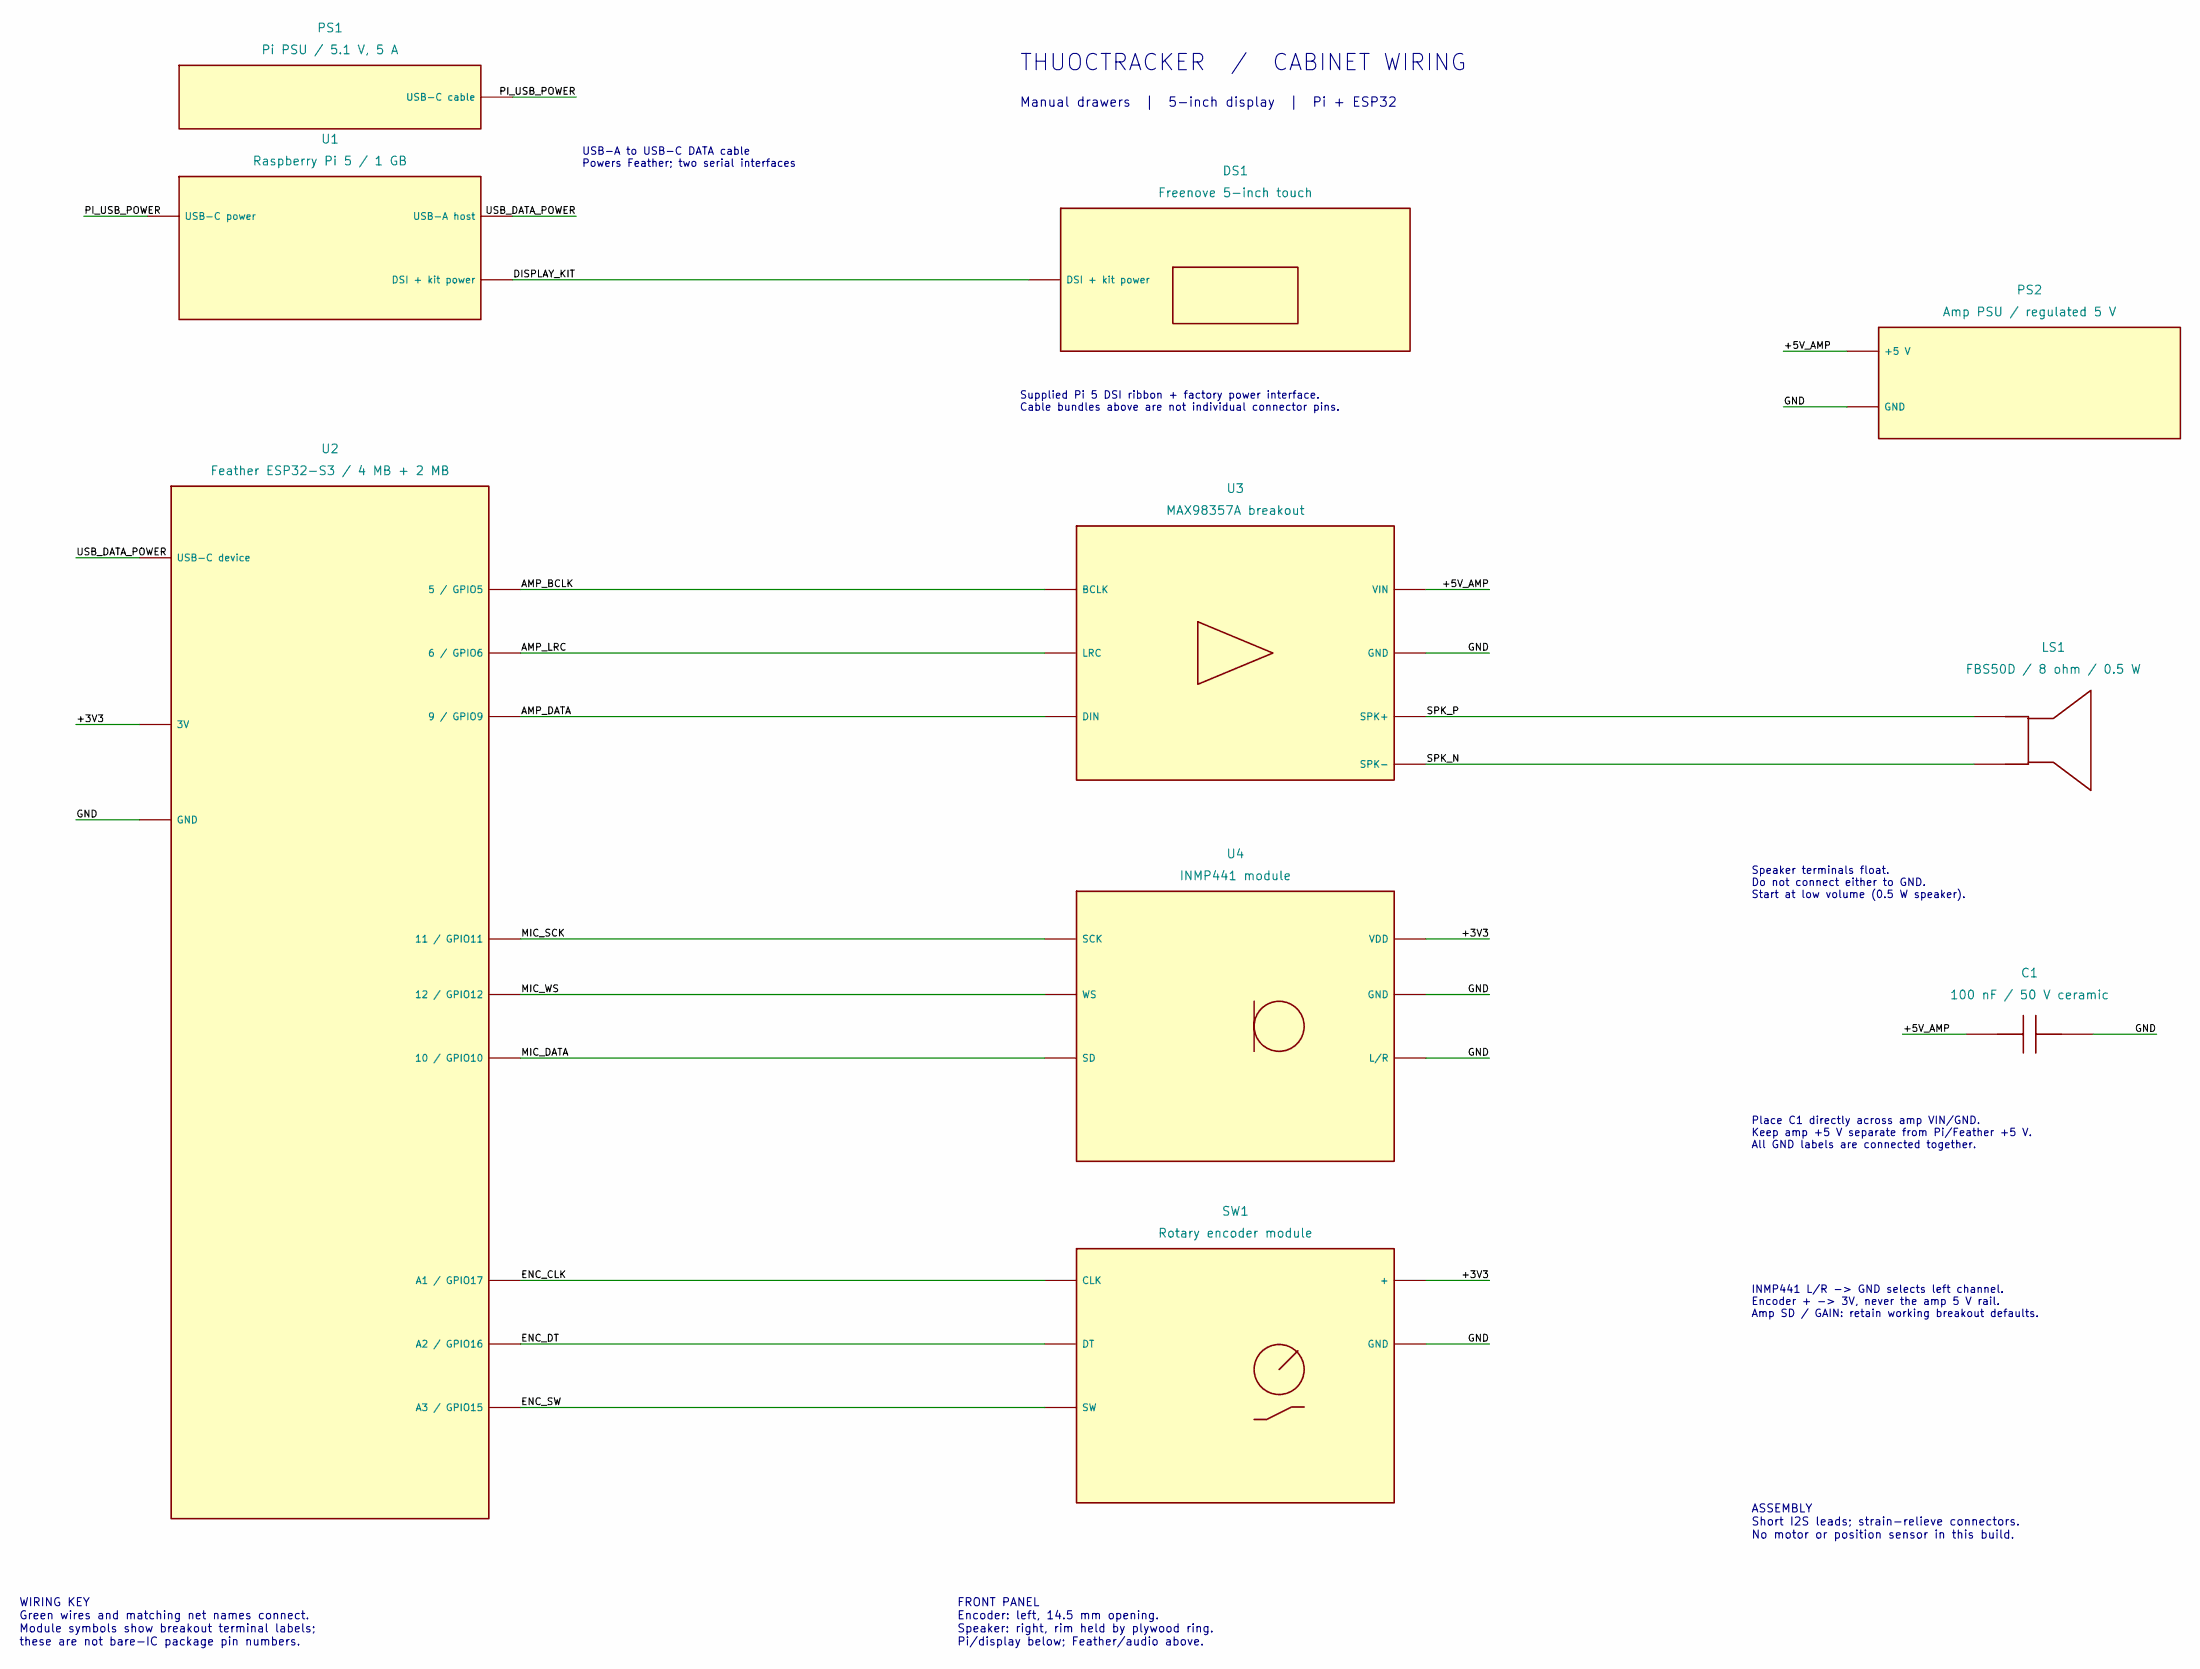
[picture p35: schematic cabinet.kicad_sch]

Parts:
C1: 100 nF / 50 V ceramic
DS1: Freenove 5-inch touch
LS1: FBS50D / 8 ohm / 0.5 W
PS1: Pi PSU / 5.1 V, 5 A
PS2: Amp PSU / regulated 5 V
SW1: Rotary encoder module
U1: Raspberry Pi 5 / 1 GB
U2: Feather ESP32-S3 / 4 MB + 2 MB
U3: MAX98357A breakout
U4: INMP441 module

Connections:
+3V3: SW1.VCC (+), U2.3V, U4.VDD
+5V_AMP: C1.1, PS2.+ (+5 V), U3.VIN
AMP_BCLK: U2.5 (5 / GPIO5), U3.BCLK
AMP_DATA: U2.9 (9 / GPIO9), U3.DIN
AMP_LRC: U2.6 (6 / GPIO6), U3.LRC
DISPLAY_KIT: DS1.KIT, U1.DSI (DSI + kit power)
ENC_CLK: SW1.CLK, U2.A1 (A1 / GPIO17)
ENC_DT: SW1.DT, U2.A2 (A2 / GPIO16)
ENC_SW: SW1.SW, U2.A3 (A3 / GPIO15)
GND: C1.2, PS2.- (GND), SW1.GND, U2.GND, U3.GND, U4.GND, U4.LR (L/R)
MIC_DATA: U2.10 (10 / GPIO10), U4.SD
MIC_SCK: U2.11 (11 / GPIO11), U4.SCK
MIC_WS: U2.12 (12 / GPIO12), U4.WS
PI_USB_POWER: PS1.USB, U1.PWR (USB-C power)
SPK_N: LS1.-, U3.SPK-
SPK_P: LS1.+, U3.SPK+
USB_DATA_POWER: U1.USB (USB-A host), U2.USB (USB-C device)

Notes on the sheet:
THUOCTRACKER / CABINET WIRING
Manual drawers | 5-inch display | Pi + ESP32
USB-A to USB-C DATA cable Powers Feather; two serial interfaces
Supplied Pi 5 DSI ribbon + factory power interface. Cable bundles above are not individual connector pins.
Speaker terminals float. Do not connect either to GND. Start at low volume (0.5 W speaker).
Place C1 directly across amp VIN/GND. Keep amp +5 V separate from Pi/Feather +5 V. All GND labels are connected together.
INMP441 L/R -> GND selects left channel. Encoder + -> 3V, never the amp 5 V rail. Amp SD / GAIN: retain working breakout defaults.
WIRING KEY Green wires and matching net names connect. Module symbols show breakout terminal labels; these are not bare-IC package pin numbers.
FRONT PANEL Encoder: left, 14.5 mm opening. Speaker: right, rim held by plywood ring. Pi/display below; Feather/audio above.
ASSEMBLY Short I2S leads; strain-relieve connectors. No motor or position sensor in this build.
