minhpham1810/thuoctracker/(commit log)

2026-10-24 Backend: working API on sample data, per TEAM.md contract
2026-10-24 Add repo-based team sync: Status board in TEAM.md, sync rules for agents
2026-10-24 Backend: patient chat, Expo push registration, alerts via push + SMS
2026-10-24 Mobile app (Expo): roles, patient overview, doctor patient list, per-patient chat, notifications
2026-10-24 Frontend: Next.js doctor dashboard and cabinet touchscreen
    Replaces the static web/doctor and web/cabinet pages with a Next.js 16 app
    in web/. /doctor shows patients, prescription cards per slot, dose history,
    live alerts, and add-medicine from a label photo (/ai/label). /cabinet is
    the Pi kiosk screen: big prompt, glowing slot, "I took it" button.
    The browser calls /api/*, which next.config.ts proxies to the backend.
    Updates README, CLAUDE.md and the TEAM.md status/ownership to match.
2026-10-24 Pi: cabinet loop on the TEAM.md contract, servo + camera, MOCK mode
    Per command: before photo -> open slot -> say_url or backup sound -> wait
    TAKE_SECONDS -> close slot -> after photo. The backend decides "taken".
    A failed hardware step is logged and the loop carries on (servo/camera
    fallbacks). MOCK=1 fakes every part; MOCK=servo,audio fakes only those.
    Tested on the Pi with the real camera against the backend.
2026-10-24 AI: real Gemini + ElevenLabs functions; web: voice question on cabinet, camera test on dashboard
    - ai/: read_label, count_pills, transcribe, answer, speak over REST (gemini-3.5-flash,
    ElevenLabs TTS). Key sent as a header so it never lands in logs. transcribe detects
    WAV/WebM/MP4/OGG/MP3. Offline test: python -m ai.test_ai
    - Cabinet screen: "Ask a question" records in the browser -> /ai/ask -> shows and plays the answer
    - Dashboard: "Cabinet camera test" sends before/after slot photos to test pill counting without the Pi
    - .gitignore: .DS_Store and audio/ were on one line
    - TEAM.md status lines (incl. NEED for Thanh: Chromium mic flag on the Pi kiosk)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
2026-10-24 Pi: start the cabinet loop and the kiosk screen on boot
    cabinet.service runs pi/main.py at boot and restarts it on crash.
    kiosk.sh waits for the web app, then opens /cabinet full-screen in
    Chromium and relaunches it if it closes. Settings in pi/.env
    (BACKEND_URL, PATIENT_ID, MOCK). One-time install: sh pi/setup.sh.
    Tested with a reboot on the Pi (Trixie, labwc).
2026-10-24 Pi: allow the mic for the cabinet's Ask button in the kiosk
2026-10-24 Pi: keep the kiosk on the DSI touchscreen, switch other outputs off
2026-10-24 Pi: setup.sh always loads the DSI screen driver
    Auto-detect missed the Freenove 5" screen on a warm reboot. Safe to rerun.
2026-10-24 Cabinet: 7-box grid screen; Medicine.slot is now 1-7
    The cabinet screen is now a picture of the real cabinet: boxes 1-3 and
    4-6 in two rows, box 7 a long box across the bottom. The box to open glows
    and the rest fade; each box shows pills left with refill/expiry warnings;
    tapping a box opens its details; the take screen names the box and the
    dose; a Today strip shows taken / missed / due / coming doses.
    Contract: Medicine.slot 1-3 -> 1-7 (additive) in models.py and
    web/lib/api.ts; the add-medicine picker, dashboard cards and pi/main.py
    servo channels follow. Noted in TEAM.md.
2026-10-24 Missed dose: alert doctor too, inform-only push to patient; expiring: alert doctor too
2026-10-24 Cabinet screen: dark theme and Menu button
    Menu (top-left) with Screen Light/Dark/Auto (auto: dark 7 PM-7 AM),
    Text size Normal/Large, and Today's pills: the full list of today's
    doses with box and status. The Today strip opens the same list.
    Choices are kept in the Pi's browser; the menu closes after 30 s and
    whenever a pill is due. Dark theme redefines the tokens for this screen
    only and keeps every text pair at 4.5:1 or better.
2026-10-24 feat: enhance user authentication and messaging features
    - Updated User model to include password for login.
    - Introduced Signup and Credentials models for user registration and authentication.
    - Added Session model to manage user sessions with tokens.
    - Implemented new API endpoints for user signup and login.
    - Created test suite for API endpoints, including user login and messaging functionalities.
    - Enhanced Cabinet component to display patient name and manage medicine state.
    - Added chat functionality for doctors to communicate with patients and families.
    - Improved dashboard to manage alerts and messages with a tabbed interface.
    - Updated styles for chat and alerts to improve user exper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
2026-10-24 Cabinet: one-time patient sign-in on the Pi
    /cabinet?hw=N (opened by kiosk.sh, N = PATIENT_ID) shows a setup screen
    with a big built-in keyboard; only patient N's account is accepted, so the
    screen always matches the Pi's boxes. The patient is remembered on the Pi;
    the login session is ended right away since the cabinet routes need none.
    Menu gains Switch patient (Cancel, or back after 1 min idle).
    ?patient=N still pins the patient without sign-in. kiosk.sh drops
    --incognito so the sign-in and screen settings survive restarts.
2026-10-25 Cabinet sign-in: accept any patient account
    The setup screen no longer locks to the Pi's PATIENT_ID; any patient
    account signs the screen in (doctor/family still refused). kiosk.sh
    opens plain /cabinet; an old ?hw= URL is simply ignored. The Pi's doors
    still follow PATIENT_ID, noted in kiosk.sh and pi/.env.example.
2026-10-25 Pi: ESP32-S3 audio unit (speaker + mic) over USB
    pi/esp32/ holds the CircuitPython boot.py and code.py for the board:
    a line protocol on a second USB serial port (ping, vol, play NAME,
    say N + WAV, rec SECONDS -> pcm N + samples, and btn from a talk button).
    With AUDIO=esp32, pi/main.py sends stored sounds and the backend's MP3s
    (converted to 16 kHz WAV with mpg123) to it, implements record_question,
    and turns a talk-button press into record -> /ai/ask -> play the answer.
    Bench commands: python pi/main.py esp32 ping|play|say|rec|ask.
2026-10-25 Pi: find the ESP32's data port as its non-console serial port
2026-10-25 ESP32 boot.py: free USB endpoints (no HID/MIDI) so the data port fits on the S3
2026-10-25 App: doctor opens a patient on Today; separate 'Scan a label' and 'Add by hand' buttons
2026-10-25 ESP32 audio: finish every USB write; Pi sends its own sound if the board lacks it
    code.py: usb_cdc's write can send only part of a buffer when the Pi is
    slow to read (the review's partial-write issue); write_all keeps writing
    until everything is out, so a recording is never cut short and the replies
    stay in step. A failed err reply no longer crashes the loop.
    main.py: an "err" reply keeps the connection (EspError); stale bytes are
    dropped on (re)connect; a stored sound missing on the board falls back to
    pi/sounds/NAME.mp3, converted and sent.
2026-10-25 ESP32 boot.py: hide the USB drive so the Pi's data port fits
    The S3 has 5 USB IN endpoints including the control one; console + drive
    + data port needs 6, so CircuitPython fell back to safe mode and skipped
    boot.py. Normal run: console + data port, no drive, code.py may write.
    BOOT held at RESET: drive back for editing, no data port (code.py idles).
2026-10-25 ESP32 link: ping handshake on connect; board ignores its own echoed lines
    On the real Pi the board's queued "ready" was echoed back by the Linux tty
    while the port opened, the board answered "err unknown command ready", and
    the first ping read that as its reply. The Pi now syncs on connect (ping,
    skip everything until pong); code.py also ignores its own words if echoed.
2026-10-25 ESP32 audio: answers play from RAM; speak-now cue, mic level and quiet boost
    On the real board a spoken answer timed out: code.py saved each answer to
    flash before playing it, and flash writes were too slow. Now the Pi sends raw
    16 kHz samples ("audio N", mpg123 -s), the board reads them in one go into an
    array in PSRAM and plays them with RawSample (no file, no flash wear).
    ask prints "speak now"; every recording prints its peak/average level and a
    quiet one is raised up to 20x before it goes to /ai/ask.
2026-10-25 ESP32: push.py copies files over the console port; fix the editing-mode button
    Holding BOOT through RESET puts the S3 in its ROM USB bootloader (GPIO0 is a
    strapping pin), so the old "hold BOOT while pressing RESET" never reached
    boot.py. push.py uploads files through CircuitPython's raw REPL (boot.py
    keeps the files writable from code), then reloads or resets the board.
    Editing mode is now: press RESET, then BOOT within 2 s.
2026-10-25 ESP32 push.py: retry the REPL entry and show what the board said
2026-10-25 Pi: say "I'm listening. Please ask your question." before recording
    The patient can't see the Pi's terminal. The prompt is an ElevenLabs MP3
    in the answers' voice (pi/sounds/listening.mp3, made once), played through
    the ESP32 right before the 5 s recording starts.
2026-10-25 ESP32 link: never hang on a board that stops reading; Pi reads pi/.env
    An old code.py on the board didn't know "audio", read the samples as text,
    crashed on a non-text byte, and the Pi's write of the rest waited forever.
    The Pi now gives up after a write timeout (and says to push the latest
    code.py); code.py skips non-text lines instead of crashing. Bench runs from
    a shell read pi/.env like cabinet.service, so AUDIO=esp32 needn't be exported.
2026-10-25 ESP32: the teammate's code.py (knob volume/mute, Hall, status) plus "audio"
    The board was running a teammate's code.py that added the rotary knob, the
    (disabled) Hall sensor and status, on top of the older protocol with only
    "say". This is that file, unchanged except: "audio N" (answers kept in RAM,
    what the Pi sends now), non-text lines skipped quietly, and the correct
    __name__ == "__main__" guard. boot.py's editing mode is now the knob held at
    RESET, matching code.py (BOOT at RESET starts the ROM bootloader).
2026-10-25 ESP32 audio: right buffer size; a failed audio command can't derail the next
    CircuitPython's array("h", some_bytes) takes the bytes as raw samples, so the
    buffer must be bytes(size), not bytes(size // 2) (the board answered "bytes
    length not a multiple of item size"). That failure skipped reading the audio,
    which the board then took as text ("command too long" for the next command).
    Now any setup failure drains the audio first, and the Pi re-syncs with a
    ping after a failed command that carried audio.
2026-10-25 ESP32 audio: read big answers in a loop (CircuitPython's readinto stops at half)
    common_hal_usb_cdc_serial_read compares bytes read with bytes still left, so
    one readinto() of a large buffer with a timeout returns about half. Small
    audio worked; a 70 KB prompt came back short, and the board then read the
    rest as text, stalling the Pi's write. Now the board reads into a bytearray
    in a loop (any byte count, knob still serviced) and builds the samples after.
2026-10-25 ESP32 boot.py: the version on the board (knob held at RESET = editing mode)
2026-10-25 ESP32 audio: fast reads (short blocking reads of 4 KB) for big answers
    The read loop with non-blocking reads and a sleep between them took one
    64-byte USB packet per pass: a 70 KB prompt took longer than the Pi's write
    limit. Short blocking reads (timeout 0.05 s, up to 4 KB) keep USB running
    inside CircuitPython and still avoid its stop-at-half readinto bug. The
    board's error now says how long the transfer took; the Pi allows more time.
2026-10-25 Status: ESP32 voice path works end to end on the cabinet
2026-10-25 Screen "Ask a question" uses the cabinet's ESP32 mic when the browser has none
    The Pi kiosk's browser can't reach the ESP32's mic, so the button said "I
    can't use the microphone". Now, with no browser mic, it calls the new
    POST /cabinet/{id}/ask: the backend queues an "ask" command, the Pi speaks
    the prompt, records on the ESP32, calls /ai/ask and plays the answer, and
    the screen shows "I'm listening" / "Let me check" / the answer, polling the
    new GET /cabinet/{id}/answer (every /ai/ask saves its answer in the new
    cabinet_answer table). An ask the Pi doesn't take within 30 s is dropped.
    TEAM.md contract updated.
2026-10-25 ESP32 knob: 16 audible volume steps, a tick at the new volume, easier mute
    The knob was read fine, but each click moved the level by 0.025: at the top
    (0.95-1.0) nothing was audible and it seemed dead. Now 16 steps on a loudness
    curve ((step/16)^2, start step 7 ~ 0.19), a short tick at the new level once
    the turning pauses (only when nothing is playing), and a mute press counts
    from 50 ms to 3 s (tick on unmute). status also reports volume_step.
2026-10-25 Voice answers: fast ElevenLabs model, text saved with the voice, screen polls 0.5 s
    The screen showed the answer seconds before the cabinet spoke: /ai/ask
    saved the text before generating speech with eleven_multilingual_v2
    (~1.6-2 s). Now speech uses eleven_flash_v2_5 (~0.75 s, same voice;
    ELEVENLABS_MODEL to switch), the answer is saved only once its MP3 exists,
    and the screen checks every 0.5 s. Prompt re-recorded with the fast model.
2026-10-25 Screen shows the voice answer when the cabinet starts saying it
    /ai/ask saved the answer for the screen ~2 s before the cabinet spoke (the
    Pi still downloaded, converted and sent the audio to the ESP32). Now the Pi
    posts it to the new POST /cabinet/{id}/answer as soon as the ESP32 has the
    audio (Esp32.say on_start), or anyway if playback fails; /ai/ask just
    returns {text, audio_url} again. TEAM.md contract updated.
2026-10-25 AI answers: never invent doses (empty log, unknown medicine, ungrounded facts)
    With an empty or short log Gemma 4 made doses up ("You took metformin at
    8:00 AM and 8:00 PM" for a patient with no doses, 6 of 6 tries), against the
    hard rule that answers come from the real log. answer() now replies from
    the data for an empty log or a medicine not in the log, and checks every
    medicine, pill color and time in the model's reply against the log (or
    "now"); anything else becomes DONT_KNOW and is logged.
2026-10-25 Doctor appointments: open times, patient/family booking, cancel, reminders
2026-10-25 Enhance AI answer function to include patient's medicines for better responses; update tests accordingly.
2026-10-25 Appointments as a 3-month calendar: weekly repeat, month grid for doctor (app + web) and patient booking
2026-10-25 Doctor AI: FDA label search for interactions and side effects
    DailyMed SPL labels for 38 common drugs, parsed into sections, chunked,
    embedded with MiniLM (Ollama all-minilm) and stored in Tiger Postgres with
    pgvector/pgvectorscale DiskANN and tsvector. Hybrid search fused with RRF,
    rare words only on the keyword side. GET /patients/{id}/interactions quotes
    where one label names another drug plus known pathways (no model);
    POST /ai/drugs answers from cited label passages with a grounding check.
    Dashboard: Interactions and side effects section in the patient chart.
2026-10-25 Patient 'Did you take your pill?' popup (Yes / Not yet every 30 min, up to 3 h); taken-late push
2026-10-25 Drug check: say what happened for the drug you checked
    Nothing found, no label loaded (try the generic name), already prescribed,
    or how many findings, instead of the same line as before the check; the
    button shows Checking... while it runs.
2026-10-25 Doctor dashboard: redesign the drug safety panel
    Learned from Drugs.com / Medscape interaction checkers: summary count first,
    cards sorted and badged by seriousness (here: the label section the sentence
    comes from, not an invented score), a drug list with the considered drug as a
    removable chip and autocomplete from the loaded labels, mechanism on its own
    row. Interactions and Ask the labels are tabs; Ask offers questions built from
    the patient's medicines, marks the AI summary apart from quoted label text,
    and says plainly when the labels have no answer. /interactions also returns
    the loaded drug names.
2026-10-25 Refactor Doctor Dashboard: Remove demo reset functionality and update UI styles
    - Removed the confirm reset state and associated resetDemo function from DoctorView component.
    - Updated CSS styles for the doctor dashboard to enhance the soft UI theme, including adjustments to colors, shadows, and button styles.
    - Modified global CSS variables for a more cohesive color palette and shadow effects.
    - Adjusted icon colors in the Logo component to align with the new theme.
2026-10-25 feat: add read_at field to Message model and update related types
    style: update cabinet and doctor CSS for new flat UI design
    fix: adjust button styles and colors to align with new design tokens
    refactor: modify global CSS variables for improved styling consistency
    chore: update API types to include read_at in Message type
2026-10-25 feat(auth): integrate Auth0 for authentication in mobile and web apps
    - Added `react-native-auth0` to the mobile app for Auth0 login functionality.
    - Updated login flow in the mobile app to include Auth0 option.
    - Implemented backend endpoint for Auth0 login, validating access tokens and managing user sessions.
    - Created tests for Auth0 login functionality in the backend.
    - Enhanced web app to support Auth0 login, including session management and logout handling.
    - Updated package dependencies for both mobile and web applications to include Auth0 SDK.
2026-10-25 Demo script: Part A built around demo mode's 30 s timer, Part C drug safety scene
    Part A: Mary takes only the aspirin; the cabinet's 'Did you take your
    Metformin?' question appears when it's missed; the voice questions come after,
    so their answers match the log. Part C: the dashboard's drug safety check for
    Mary (clarithromycin) and one Ask the labels question. Time budget for 5:00.
2026-10-25 hardware/schematic/fab files
